CongducPham/PRIMA-Intel-IrriS/README.md

Low-cost LoRa IoT platform for the PRIMA INTEL-IRRIS project
============================================================

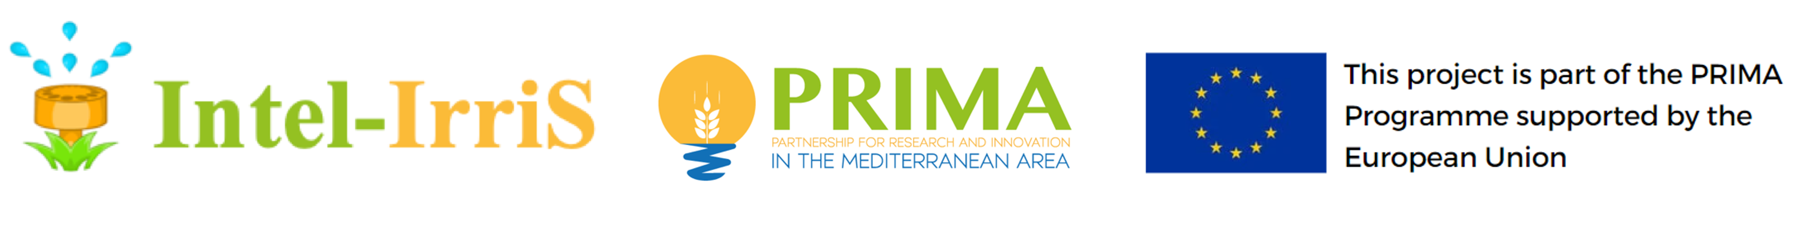
[picture p1: images/intel-irris-logo.png]


We are not maintaining this repo anymore
----------------------------------------

In 2021, we started the [PRIMA INTEL-IRRIS project](https://intel-irris.eu) and this repo. Then, in 2025, as our works in INTEL-IRRIS are continuing in the [PEPR AgriFutur project](https://iotsensingsystem.live-website.com/pepr-agroeconum-agrifutur), at time of writing, the latest edge-enabled gateway we are building on top of the general WaziGate framework provided by WAZIUP e.V is available from the dedicated [PEPR AgriFutur GitHub](https://github.com/CongducPham/PEPR_AgriFutur). Check our latest development on this PEPR AgriFutur GitHub repo. 

History
-------

- **May-24** [Final events](https://intel-irris.eu/final-intel-irris-events) in Oran (Algeria) and Rabat (Morocco) to present the results of 3 years of collaborative research and innovation.

- **Nov-21** We created the GitHub repository for the PRIMA/EU INTEL-IRRIS project. Check project [web site](http://intel-irris.eu/), the dedicated [News section](https://intel-irris.eu/news) and follow us on [Twitter](https://twitter.com/Intel_IrriS).

Quick start
-----------

The [Arduino sketch](https://github.com/CongducPham/PRIMA-Intel-IrriS/tree/main/Arduino/Intelirris_Soil_Sensor) for the soil sensor device is in the [Arduino folder](https://github.com/CongducPham/PRIMA-Intel-IrriS/tree/main/Arduino).

The INTEL-IRRIS gateway part is based on the [WaziGate](https://github.com/Waziup/WaziGate) framework.

The WaziGate generic framework is enhanced with INTEL-IRRIS specific UI and irrigation data processing. These additional contributions are in the `Gateway` folder **but the SD card image has already everything installed**.

The INTEL-IRRIS WaziGate SD card image is available on [http://intel-irris.eu/results](http://intel-irris.eu/results). It is configured by default for 868MHz frequency band. To use 433MHz frequency band, see the [433MHz auto-configuration mechanism](https://github.com/CongducPham/PRIMA-Intel-IrriS/tree/main/Gateway/boot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).

Default configuration for the gateway
---

- LoRaWAN mode (single channel)
- Cayenne LPP data format
- EU868 band (suitable for Algeria. For Morocco, need to use 433MHz)
- 2 pre-configured devices with address 26011DAA and 26011DB1
- 26011DAA is a soil humidity device with the capacitive SEN0308 sensor
	- Device name is `SOIL-AREA-1`
	- `temperatureSensor_0` as the internal default logical sensor on the WaziGate for soil humidity data. Display will show `Soil Humidity Sensor/Raw value from SEN0308`
	- `temperatureSensor_5` as the internal default logical sensor on the WaziGate for the soil temperature data if a DS18B20 is connected. Display will show `Soil Temperature Sensor/degree Celcius`
	- `analogInput_6` as the internal default logical sensor for battery voltage. Display will show `Battery voltage/volt, low battery whebn lower than 2.85V`
- 26011DB1 is a soil humidity device with the Watermark WM200 tensiometer sensor
	- Device name is `SOIL-AREA-2`
	- `temperatureSensor_0` as the internal default logical sensor on the WaziGate for soil humidity data. It provides the converted resistance value in centibar, Taking into account the soil temperature data. Display will show `Soil Humidity Sensor/centibars from WM200`
	- `temperatureSensor_1` as the internal default logical sensor on the WaziGate for soil humidity data. It provides the raw resistance value measured from the Watermark sensor. The value is scaled down by 10, so to get the real resistance value one must multiply by 10. Display will show `Soil Humidity Sensor/scaled value from WM200 real=x10`	
	- `temperatureSensor_5` as the internal default logical sensor on the WaziGate for the soil temperature data if a DS18B20 is connected. Display will show `Soil Temperature Sensor/degree Celcius`
	- `analogInput_6` as the internal default logical sensor for battery voltage. Display will show `Battery voltage/volt, low battery whebn lower than 2.85V`

Insert the SD card in the Raspberry Pi and then power the RPI. The INTEL-IRRIS WaziGate is ready when the main INTEL-IRRIS screen appears on the OLED indicating `SOIL-AREA-1` and `SOIL-AREA-2` devices. You may see a succession of `[ Internet NO ]` and/or `[ Internet OK ]` and black screen before the main INTEL-IRRIS screen appears on the OLED.

More information in the [`Gateway`](https://github.com/CongducPham/PRIMA-Intel-IrriS/tree/main/Gateway) folder.

**Note: The 2 default devices are created on first boot with the auto-configuration mechanism. Consider about 5mins as normal for boot time. If you change the frequency band, the gateway will take more time to start as it needs to boot twice. Therefore 10mins would be needed for first start to have the main INTEL-IRRIS screen on the OLED.**

Tutorials
---------

General presentation of the PRIMA INTEL-IRRIS project

- [Intel-IrriS’s presentation slides](http://cpham.perso.univ-pau.fr/LORA/INTEL-IRRIS/Intel-Irris-presentation.pdf)

1 general online tutorial on IoT, Arduino, LoRa, AI 

- [Arduino-Sensor-LoRa tutorial](https://cpham.perso.univ-pau.fr/LORA/WAZIUP/tuto/index.html)

The generic low-cost IoT framework from which the INTEL-IRRIS platform is derived

- [Low-cost IoT framework](https://github.com/CongducPham/LowCostLoRaGw)

The WaziGate edge-enabled IoT gateway framework developed by WAZIUP

- [WaziGate presentation](https://www.waziup.io/documentation/wazigate/)

INTEL-IRRIS specific tutorials

- [Building the INTEL-IRRIS IoT platform. Part 1: soil sensor device (all versions)](https://github.com/CongducPham/PRIMA-Intel-IrriS/blob/main/Tutorials/Intel-Irris-IOT-platform-all-version.pdf). Slides. Related videos: Video n°1, Video n°2 and Video n°3.

- [Building the INTEL-IRRIS IoT platform. Part 1: soil sensor device (IRD PCB and IRD PCBA v4.1)](https://github.com/CongducPham/PRIMA-Intel-IrriS/blob/main/Tutorials/Intel-Irris-IOT-platform-PCBv4-PCBA.pdf). Slides. Related videos: Video n°1, Video n°2 and Video n°3.

- [Building the INTEL-IRRIS IoT platform. Part 2: edge-enabled gateway (WaziGate)](https://github.com/CongducPham/PRIMA-Intel-IrriS/blob/main/Tutorials/Intel-Irris-edge-gateway.pdf). Slides. Related videos: Video n°4.

- [Building the INTEL-IRRIS IoT platform. Part 3: the INTEL-IRRIS starter-kit (WaziGate)](https://github.com/CongducPham/PRIMA-Intel-IrriS/blob/main/Tutorials/Intel-Irris-starter-kit-advanced-guide.pdf). Slides. Related videos: Video n°5.

- [The INTEL-IRRIS starter-kit. Maker Guide.](https://github.com/CongducPham/PRIMA-Intel-IrriS/blob/main/Tutorials/Intel-Irris-starter-kit-maker-guide.pdf). Slides.

- [The INTEL-IRRIS starter-kit. User Guide.](https://github.com/CongducPham/PRIMA-Intel-IrriS/blob/main/Tutorials/Intel-Irris-starter-kit-user-guide.pdf). Slides.

- [The INTEL-IRRIS starter-kit. Installation Guide.](https://github.com/CongducPham/PRIMA-Intel-IrriS/blob/main/Tutorials/Intel-Irris-starter-kit-installation-guide.pdf). Slides.

- Video n°1: [Build the LoRa IoT microcontroller platform for the PRIMA INTEL-IRRIS project](https://youtu.be/3jdQ0Uo0phQ). **YouTube video**.

- Video n°2: [Build the LoRa IoT soil sensor device for the PRIMA INTEL-IRRIS project](https://youtu.be/zcazzDbXvHk). **YouTube video**.

- Video n°3: [Connect the SEN0308 capacitive sensor and test LoRa data transmission on the Edge IoT gateway](https://youtu.be/n0YGan7_vUc). **YouTube video**.

- Video n°4: [Demonstrating the INTEL-IRRIS soil sensor device & WaziGate framework for intelligent irrigation in-the-box](https://youtu.be/j-1Nk0tv0xM). **YouTube video**. 

- Video n°5: [Non-technical video showing the production of the starter-kit](https://youtu.be/5nznRcIoe40). **YouTube video**.

- Video n°6. [Showcasing the starter-kit for the Smallholder Piloting Program](https://youtu.be/z5NL3dBHQ6c). **YouTube video**.

- [Building the INTEL-IRRIS IoT platform. Annex 1: ordering the PCBs, including PCBA](https://github.com/CongducPham/PRIMA-Intel-IrriS/blob/main/Tutorials/Intel-Irris-PCB-update-PCBA.pdf). Slides.

- Video n°9. [Tutorial showing how to order the fully assembled INTEL-IRRIS PCBA](https://youtu.be/ueNRfBzCXiU). **YouTube video**.

- [List of hardware parts for the INTEL-IRRIS soil sensor device](https://github.com/CongducPham/PRIMA-Intel-IrriS/blob/main/Tutorials/Intel-IrriS-low-cost-sensor-hardware-parts.pdf). Document.

The starter-kit
---------

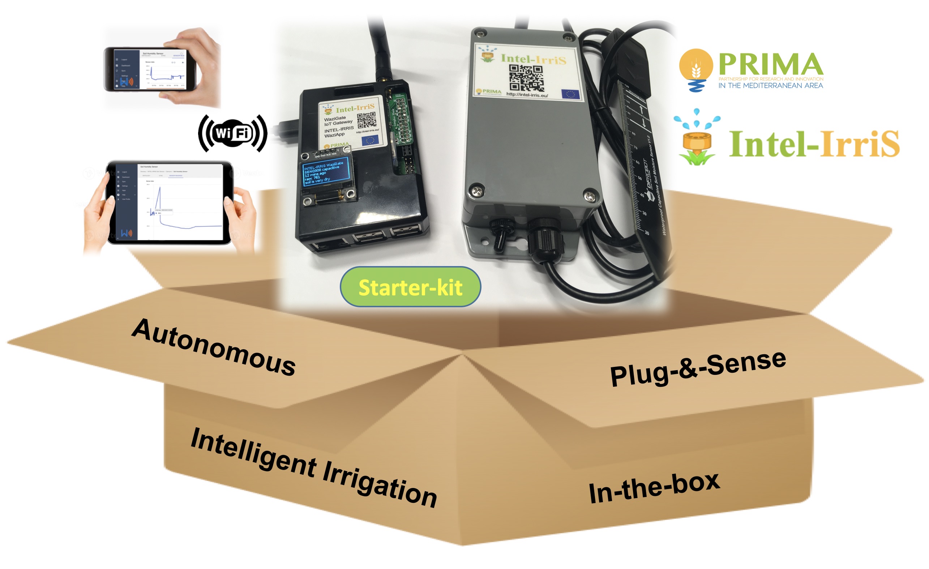
[picture p2: images/starter-kit-bg-white.jpg]




Enjoy!
C. Pham
Coordinator of PRIMA INTEL-IRRIS
