CongducPham/PRIMA-Intel-IrriS/Gateway/oled/README.md

This is a breakdown of all the steps to install the INTEL-IRRIS OLED service on top of the generic WaziGate distribution. The `install.sh` script actually does the installation. 

Expand filesystem if needed
---------------------------

	> sudo raspi-config
	
PIP3 on WaziGate
----------------

	> sudo apt install python3-pip
	
OLED on WaziGate
----------------

More info from https://learn.adafruit.com/monochrome-oled-breakouts/python-setup

	> sudo pip3 install adafruit-circuitpython-ssd1306
	> sudo apt-get install python3-pil
	
then see small example from https://learn.adafruit.com/monochrome-oled-breakouts/python-usage-2

The INTEL-IRRIS OLED service
----------------------------

	> sudo cp intel-irris-oled-service.service.txt /etc/systemd/system/intel-irris-oled-service.service
	> sudo systemctl enable intel-irris-oled-service.service
	
How the OLED service works?
---------------------------

The OLED service (`intel-irris-oled-service.service.txt`) takes some configuration definitions from `oled_config.py`. Then, it will try to discover all devices with either "SEN0308" or "WM200" in their sensor name or sensor kind.

It will display a main screen then a screen saver	by cycling sequentially through all discovered devices. It will display in the screen saver a visual interface to indicate the soil humidity level.



More information on the OLED screen can be found in the [starter-kit slides](https://github.com/CongducPham/PRIMA-Intel-IrriS/blob/main/Tutorials/Intel-Irris-starter-kit.pdf).
