CongducPham/PRIMA-Intel-IrriS/Datasets/plot_scripts/README.md

*Plot scripts*
============================================================

	- new file:   plot_csv_Bondy.py
	- new file:   plot_csv_template.py
	- new file:   plot_json.py

These scripts sum up in plots a dataset based on values extracted from a gateway.
Three formats are supported:
- JSON from Gateway's extraction script
- CSV with a single time column from Gateway's extraction script
- CSV from WaziApp UI's extraction; currently a template of the CSV with a two-line header.
