CongducPham/PRIMA-Intel-IrriS/images/INTEL-IRRIS-wazigate-default-sensor-data.png

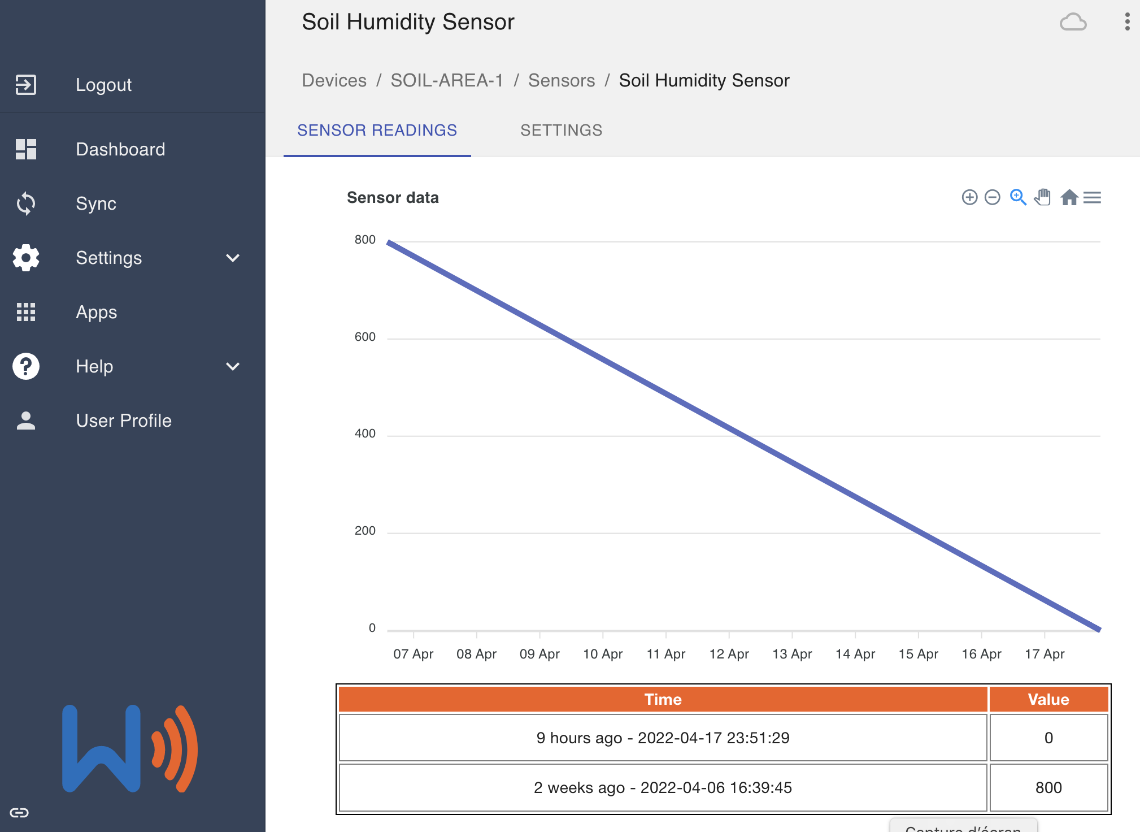
images/INTEL-IRRIS-wazigate-default-sensor-data.png
