CongducPham/PRIMA-Intel-IrriS/images/ProMini-RFM95W-bottom.png

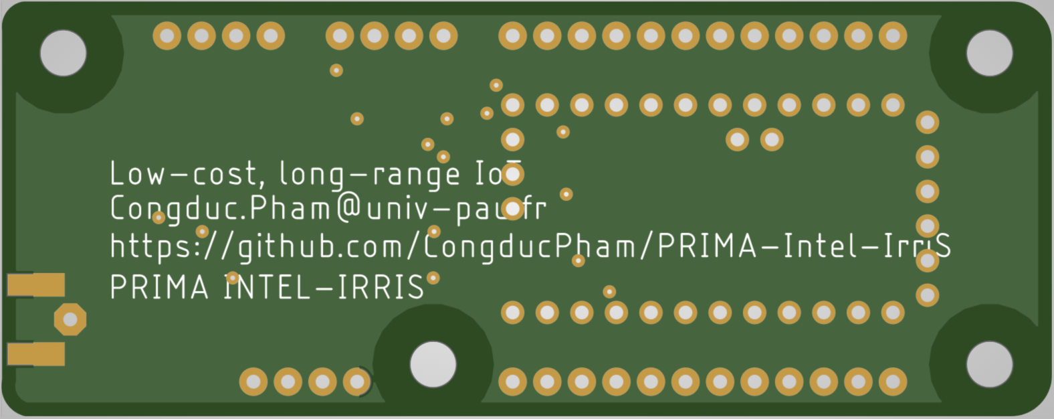
images/ProMini-RFM95W-bottom.png
