CongducPham/PRIMA-Intel-IrriS/images/ProMini-SX128X-bottom.png

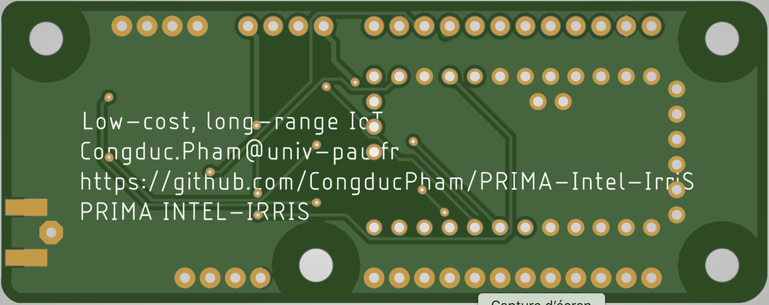
images/ProMini-SX128X-bottom.png
