CongducPham/PRIMA-Intel-IrriS/PCBs/IRD_PCB_5/BOM_SMT_TB_RAK3172_868_IISS_PCB5.xlsx

Name | Designator | Footprint | Quantity | Supplier | Supplier Part | alternative
4.7uF | C2,C5,C6,C7 | 1206 | 4 | LCSC | C92837
100nF | C1,C8 | 603 | 2 | LCSC | C106221 | C42998 | C106221
PZ254V-11-06P | CN25 | HDR-TH_6P-P2.54-V-M | 1 | LCSC | C492405
1k | R11 | 603 | 1 | LCSC | C22548
RAK3172 (EU868, WITHOUT IPEX) | U2 | LCC-40_L15.6-W15.0-P1.00_RAK3172 | 1 | LCSC | C5452091 | C2886287 | C5452091 | C19723908 | C19723904
PZ254V-11-04P | CN1,H2 | HDR-TH_4P-P2.54-V-M | 2 | LCSC | C492403
XY308-2.54-6P | CN8 | CONN-TH_XY308-2.54-6P | 1 | LCSC | C915915 | C915915 | C3817456 | C2922601 | C5188446
XY308-2.54-7P | CN3 | CONN-TH_XY308-2.54-7P | 1 | LCSC | C915916
A2541HWV-12P | CN21,CN20 | HDR-TH_12P-P2.54-V-F | 2 | LCSC | C2905419
A2541HWV-3P | CN22 | HDR-TH_3P-P2.54-V-F-1 | 1 | LCSC | C541850 | C541850 | C22368237 |  | C146243
KH-A2541HWV-2P | CN23 | HDR-TH_2P-P2.54-V-F | 1 | LCSC | C124411 | C541849 | C22368236 | C22438152 | C124411
HJ-SMA716 | RF1 | SMA-SMD_HJ-SMA716 | 1 | LCSC | C496550
TPRT9080-33GJ5 | U1 | SOT-23-5_L2.9-W1.6-P0.95-LS2.8-BR | 1 | LCSC | C841192 | C2959864
SMBJ5.0A | D2 | SMB(DO-214AA) | 1 | LCSC | C473804
10k | R13,R7 | 603 | 2 | LCSC | C98220
4.7k | R9 | 603 | 1 | LCSC | C99782
330pF | C3 | 603 | 1 | LCSC | C2181158
100k | R4,R1,R2,R6 | 603 | 4 | LCSC | C14675
430K | R5 | 603 | 1 | LCSC | C482869
IRLML5203 | Q1,Q2,Q3 | SOT-23-3_L2.9-W1.3-P0.95-LS2.4-BR | 3 | LCSC | C518778
BSS138_C400505 | Q4 | SOT-23-3_L2.9-W1.3-P1.90-LS2.4-BR | 1 | LCSC | C2874697
68 (NC for lithium) | R17 | 603 | 1 | LCSC | C126362
33nF | C4 | 603 | 1 | LCSC | C106856
SS14S-SMA | D1 | SMA_L4.3-W2.6-LS5.0-RD | 1 | LCSC | C2837270
