CongducPham/PRIMA-Intel-IrriS/Tutorials/Intel-Irris-IOT-platform-PCBv5-PCBA.pdf

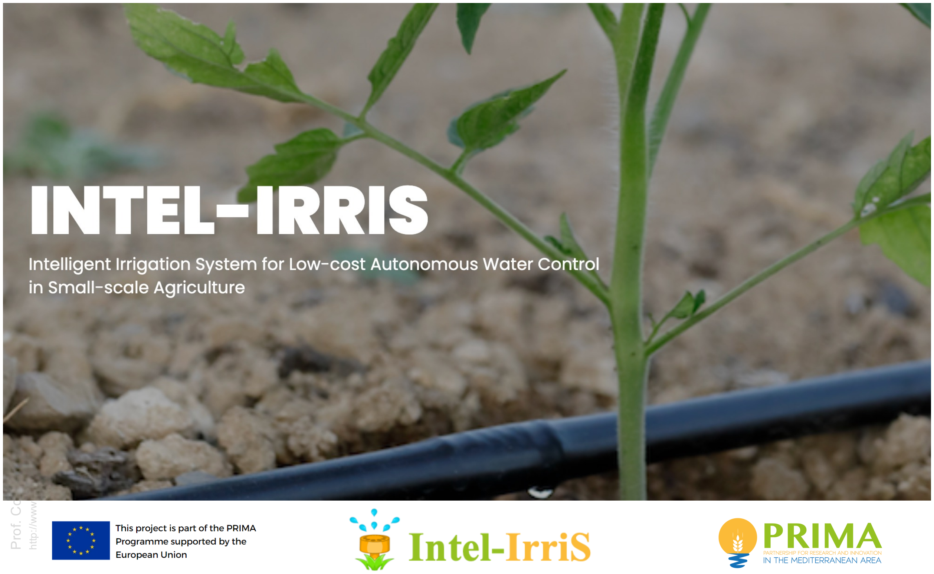
[picture p39: page 1]

1

Prof. Congduc Pham

http://www.univ-pau.fr/~cpham

### Intelligent Irrigation System for Low-cost Autonomous Water Control in Small-scale Agriculture

# Building the INTEL-IRRIS LoRa IoT platform Part 1: soil sensor device

## (annex for IRD PCB v5 – RAK3172)

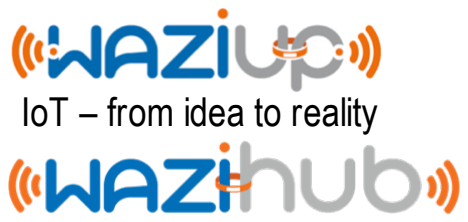
[picture p40: figure]
IoT – from idea to reality
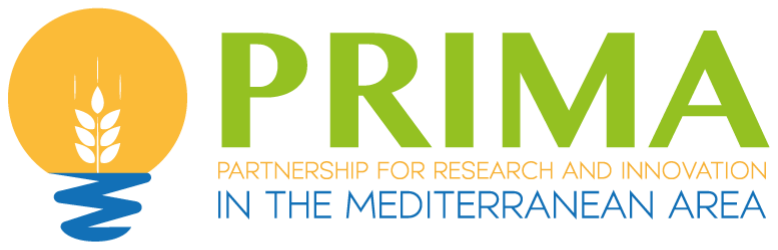
[picture p41: figure]

Prof. Congduc Pham
http://www.univ-pau.fr/~cpham Université de Pau, France

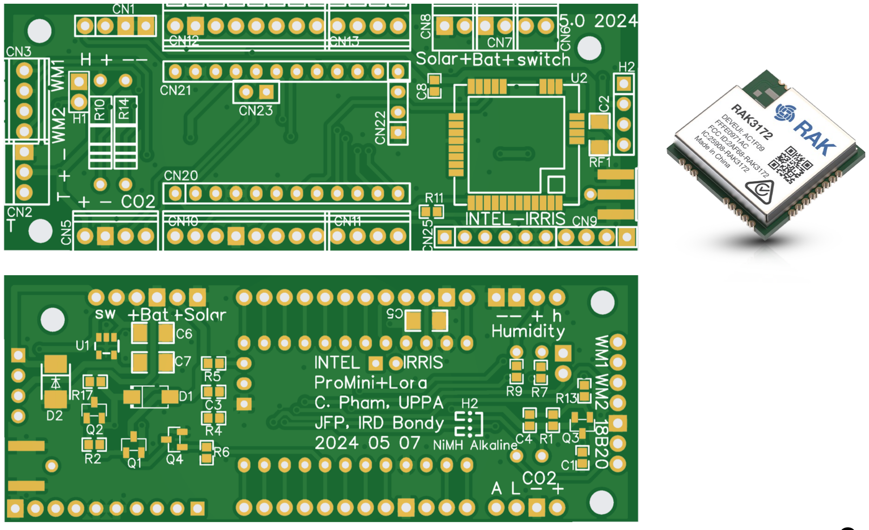
[picture p42: figure]
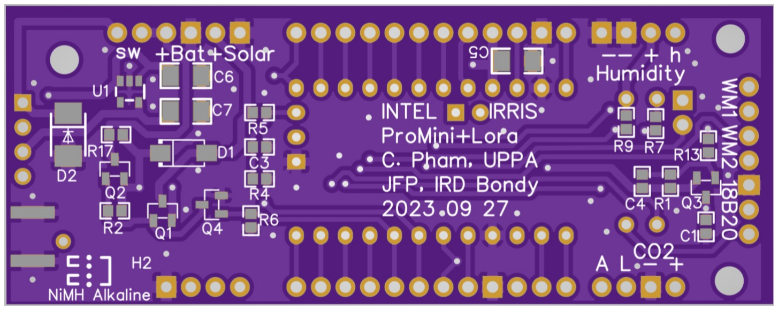
[picture p43: figure]

3

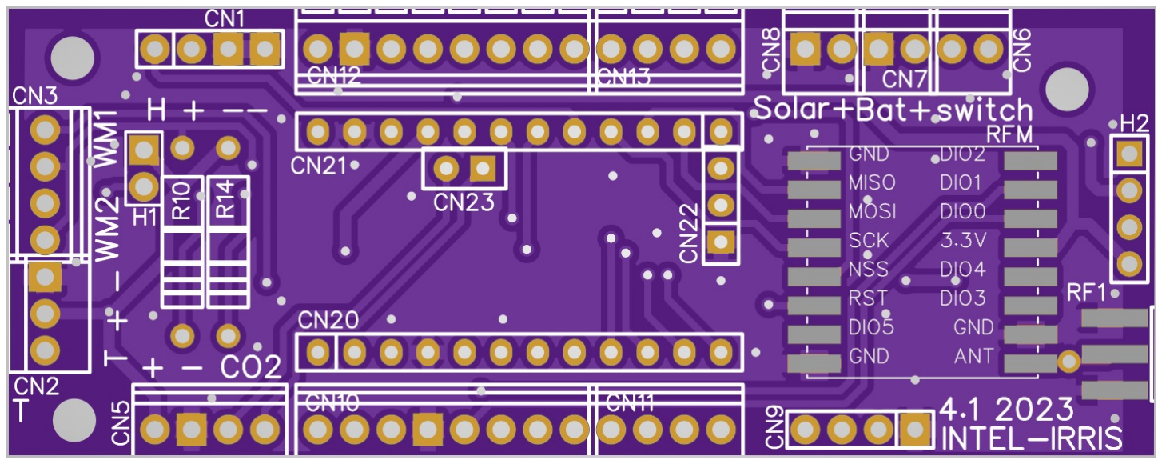
[picture p44: figure]

Prof. Congduc Pham

http://www.univ-pau.fr/~cpham

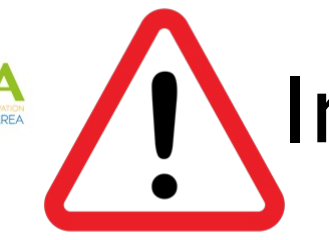
[picture p45: figure]

## Important

⊙ This tutorial is an update for the IRD PCB v5 based on the RAK3172 radio module
⊙ Reader MUST first look at the tutorial presenting the IRD PCB v4.1
⊙ This tutorial only presents the differences between the 2 versions

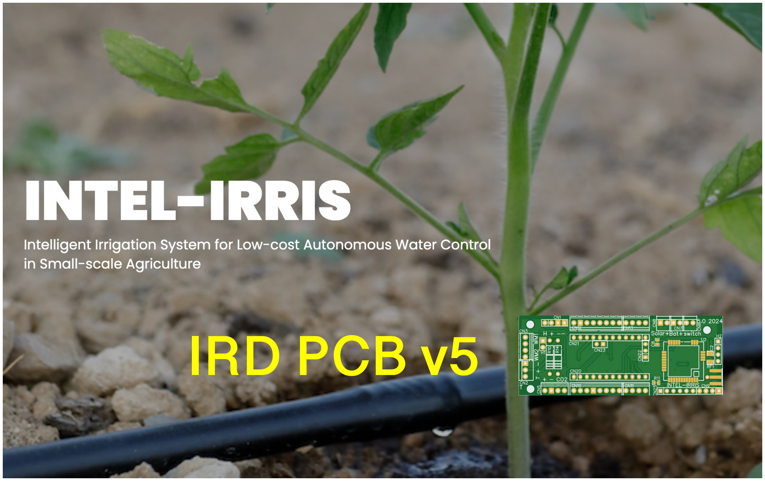
[picture p46: page 4]

# IRD PCB v5

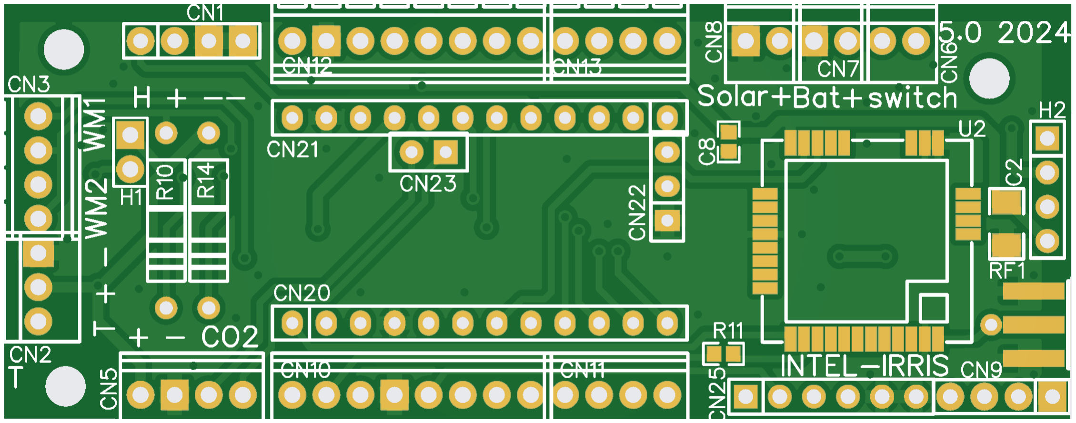
[picture p47: figure]
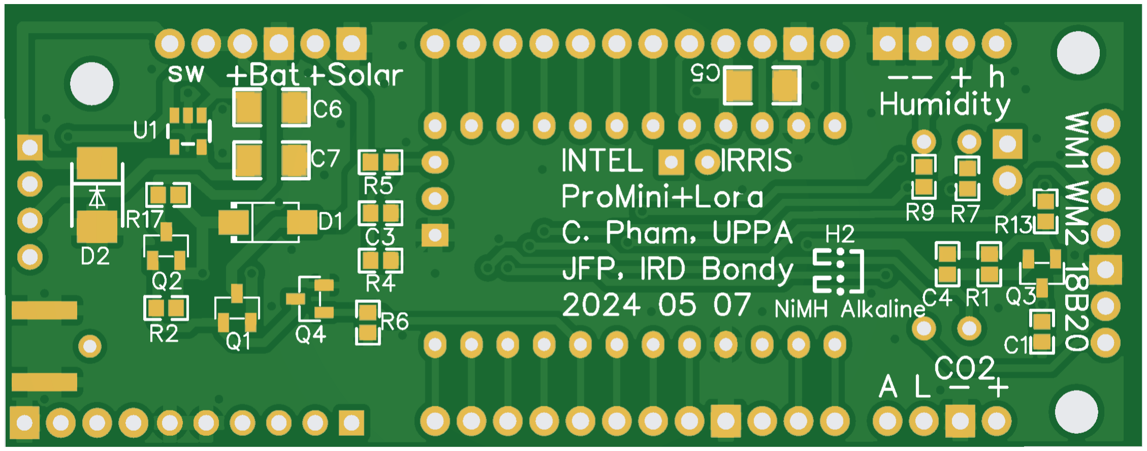
[picture p48: figure]

5

Prof. Congduc Pham

http://www.univ-pau.fr/~cpham

## The IRD PCB v5 – raw version

⊙ You can order the raw version of the IRD PCB, which means only the PCB, without any electronic components soldered by the manufacturer
⊙ It is the so-called
DIY approach
⊙ The raw version is not
intended to have solar
charging capabilities

## Electronic parts – starter-kit version

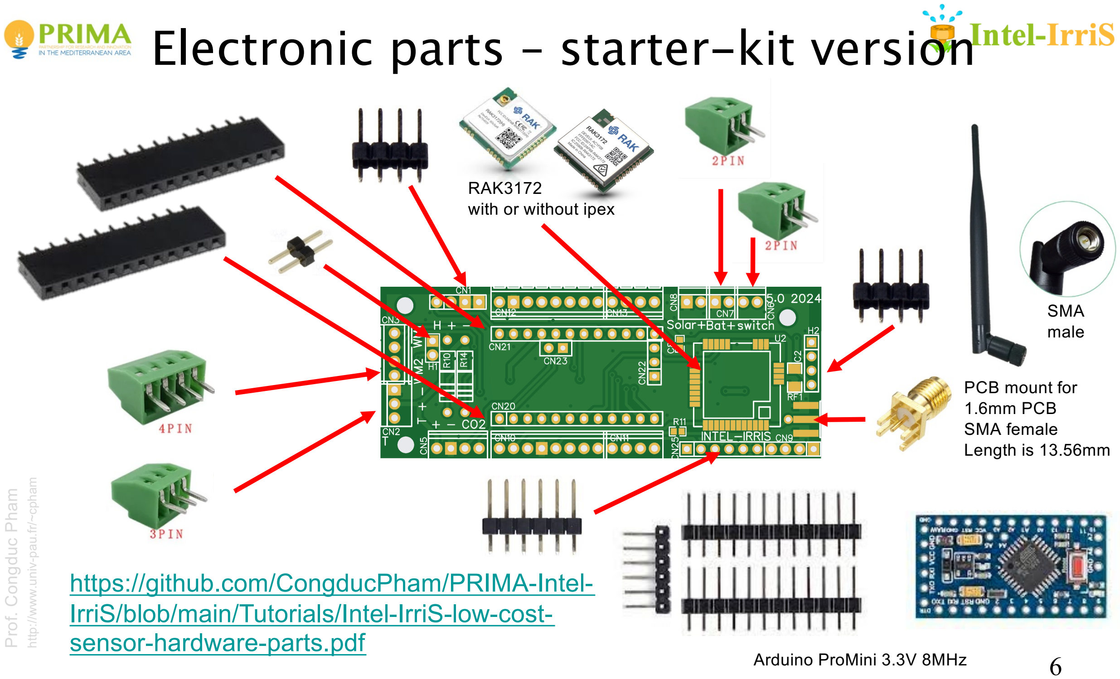
[picture p49: page 6]

6

Prof. Congduc Pham

http://www.univ-pau.fr/~cpham

PCB mount for
1.6mm PCB
SMA female
Length is 13.56mm

Arduino ProMini 3.3V 8MHz

SMA
male

https://github.com/CongducPham/PRIMA-Intel-IrriS/blob/main/Tutorials/Intel-IrriS-low-cost-sensor-hardware-parts.pdf (https://github.com/CongducPham/PRIMA-Intel-IrriS/blob/main/Tutorials/Intel-IrriS-low-cost-sensor-hardware-parts.pdf)

RAK3172
with or without ipex

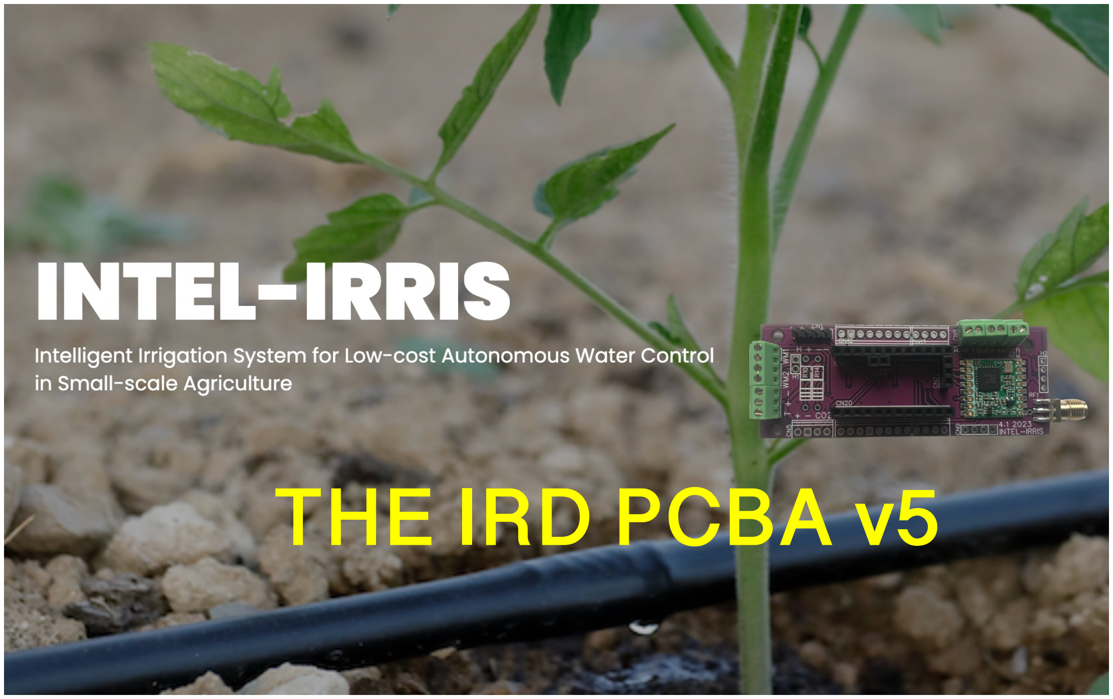
[picture p50: page 7]

# THE IRD PCBA v5

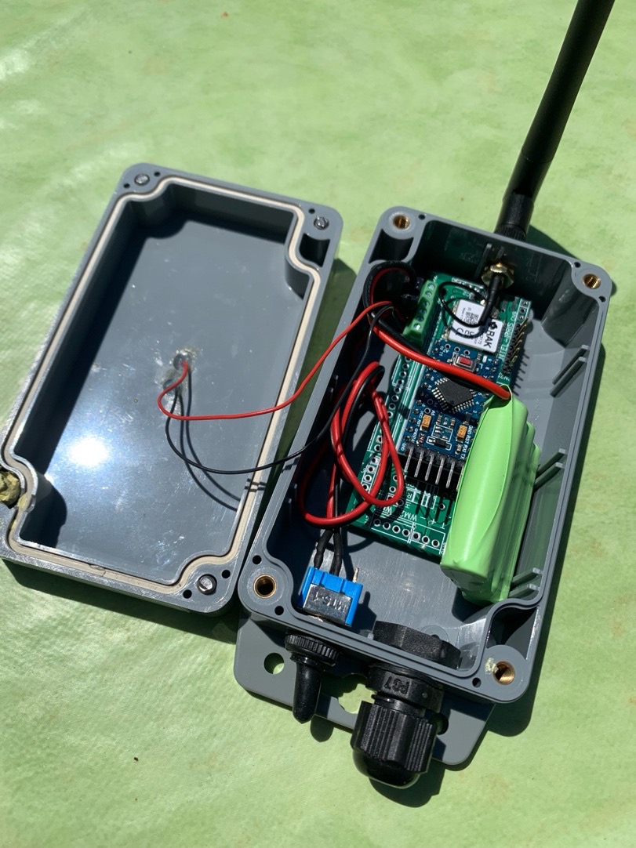
[picture p51: figure]

8

Prof. Congduc Pham

http://www.univ-pau.fr/~cpham

## Soil device with PCBA v5, final result

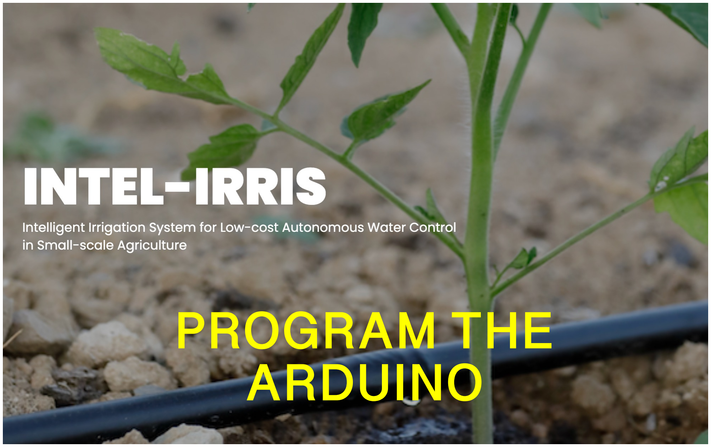
[picture p52: page 9]

# PROGRAM THE ARDUINO

## Config for IRD PCB v5 (1)

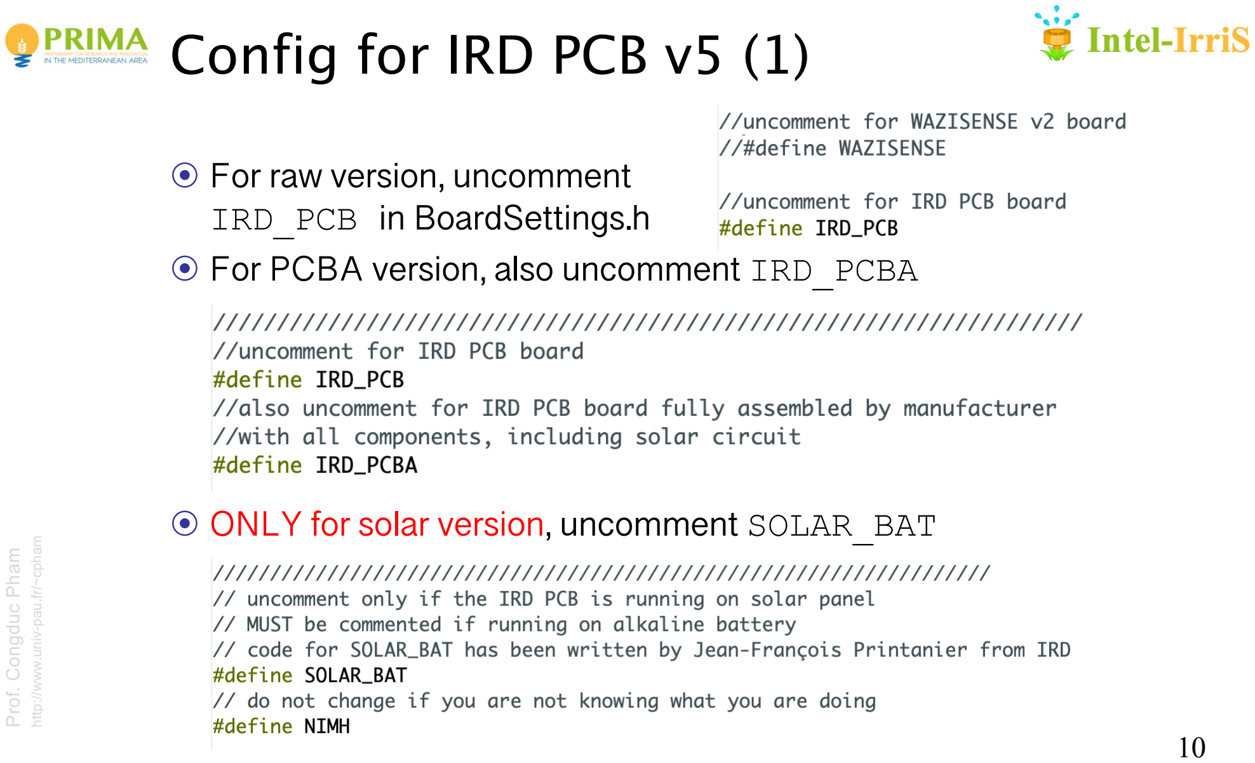
[picture p53: page 10]

10

Prof. Congduc Pham

http://www.univ-pau.fr/~cpham

⊙ For raw version, uncomment
IRD_PCB in BoardSettings.h
⊙ For PCBA version, also uncomment IRD_PCBA

⊙ ONLY for solar version, uncomment SOLAR_BAT

11

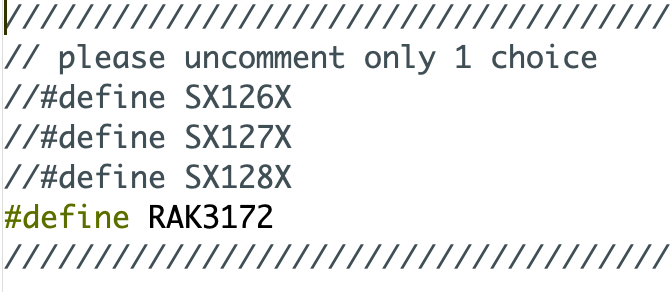
[picture p54: figure]

Prof. Congduc Pham

http://www.univ-pau.fr/~cpham

## Config for IRD PCB v5 (2)

⊙ Uncomment SOFT_SERIAL_DEBUG in BoardSettings.h

⊙ Uncomment RAK3172 in RadioSettings.h

12

Prof. Congduc Pham

http://www.univ-pau.fr/~cpham

## Serial monitor with IRD PCB v5

⊙ After flashing the Arduino, it is usually desirable to watch at the text output from the Arduino IDE serial monitor to check that everything went OK
⊙ With IRD PCB v5, the RAK radio module is controlled by AT commands received on its serial port and sent by the Arduino on its serial port (baud rate is normally set to 38400)
⊙ Therefore, Arduino's TX/RX pins are connected to the
RAK3172 and the serial monitor used traditionally to look at text output can not use the default Arduino TX/RX pins
⊙ The IRD PCB v5 uses a software defined serial port for the text output where only TX is defined on digital pin 2

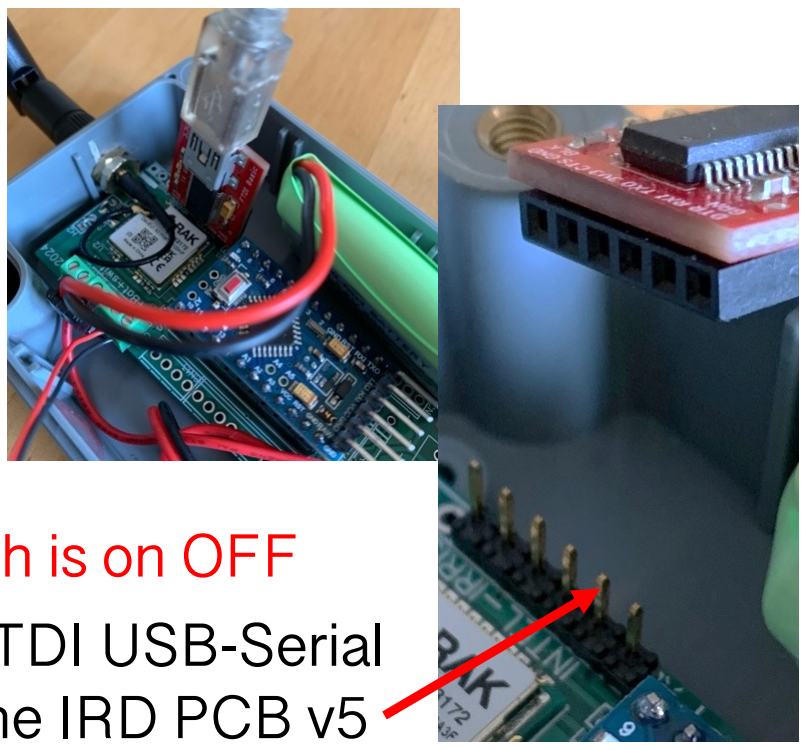
[picture p55: figure]

13

Prof. Congduc Pham

http://www.univ-pau.fr/~cpham

## Connect the FTDI USB-Serial

⊙ After flashing the Arduino with the FTDI USB-Serial cable (left photo), unplug it in order to plug it again on the dedicated debug header on the IRD PCB v5 (middle & right photo)

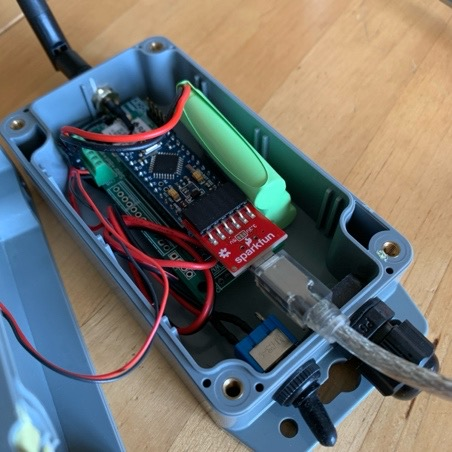
[picture p56: figure]
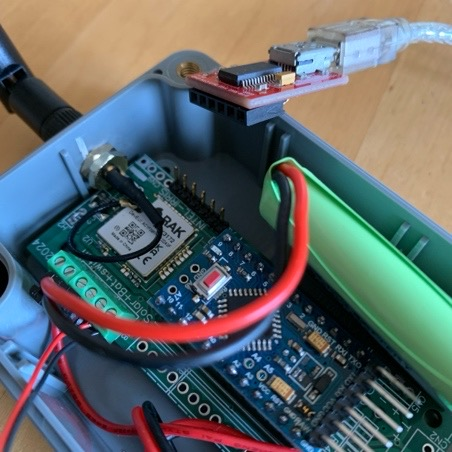
[picture p57: figure]

⊙ Battery should be connected, but switch is on OFF
⊙ Be sure to connect the RX pin of the FTDI USB-Serial to the TX pin of the debug header on the IRD PCB v5

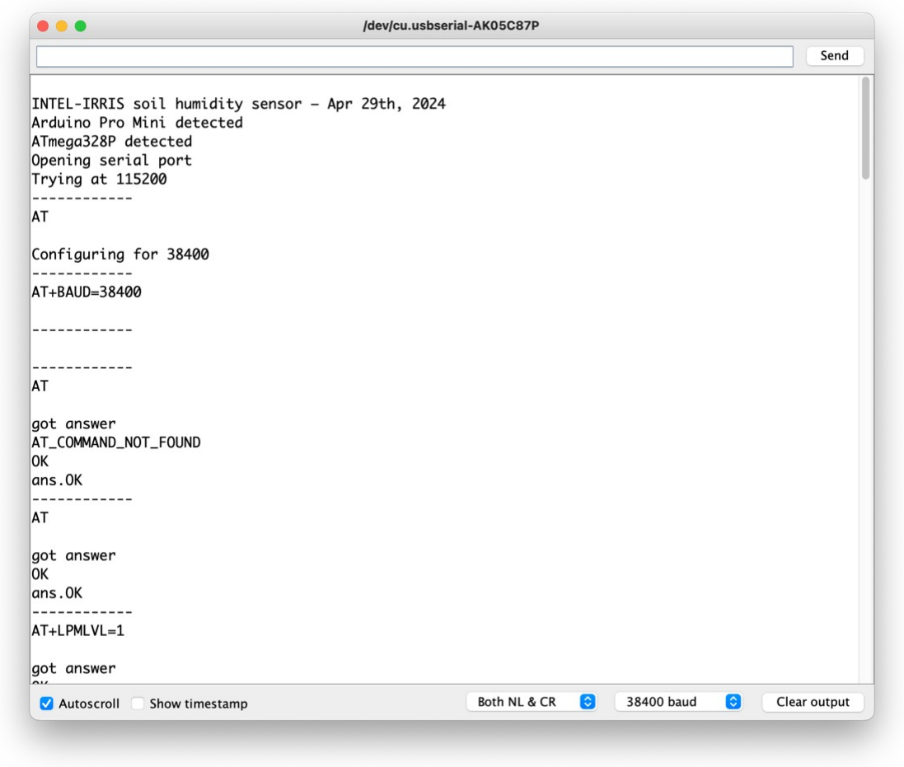
[picture p58: figure]

14

Prof. Congduc Pham

http://www.univ-pau.fr/~cpham

## Getting text output from the board

⊙ Order of steps is important!

Open serial monitor,
you should see nothing

Set baud rate to 38400

Switch ON the board

See output from board

Check that
transmission is OK

15

Prof. Congduc Pham

http://www.univ-pau.fr/~cpham

## Annex: RAK3172 baud rate

⊙ Latest version of RAK3172 is using by default (factory setting) a baud rate of 115200, which is too fast (mostly for RX) for the Arduino Pro mini based on ATMega328P microcontroller
⊙ The INTEL-IRRIS code is actually reprogramming the
RAK3172 to use a baud rate of 38400, therefore you do not need to worry about setting the correct baud rate for RAK3172, especially with the fully assembled version of the PCB where the RAK3172 is provided by the PCB manufacturer

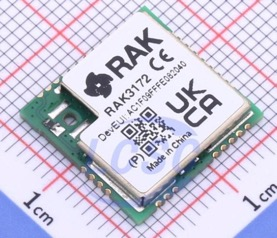
[picture p59: figure]
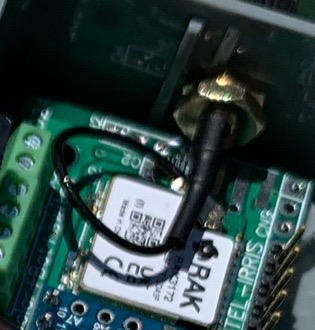
[picture p60: figure]

16

Prof. Congduc Pham

http://www.univ-pau.fr/~cpham

## Annex: IPEX or not IPEX?

⊙ The BOM file for the PCBA fully assembled is using the RAK3172 without the IPEX connector because we prefer to have a robust soldered RF connector

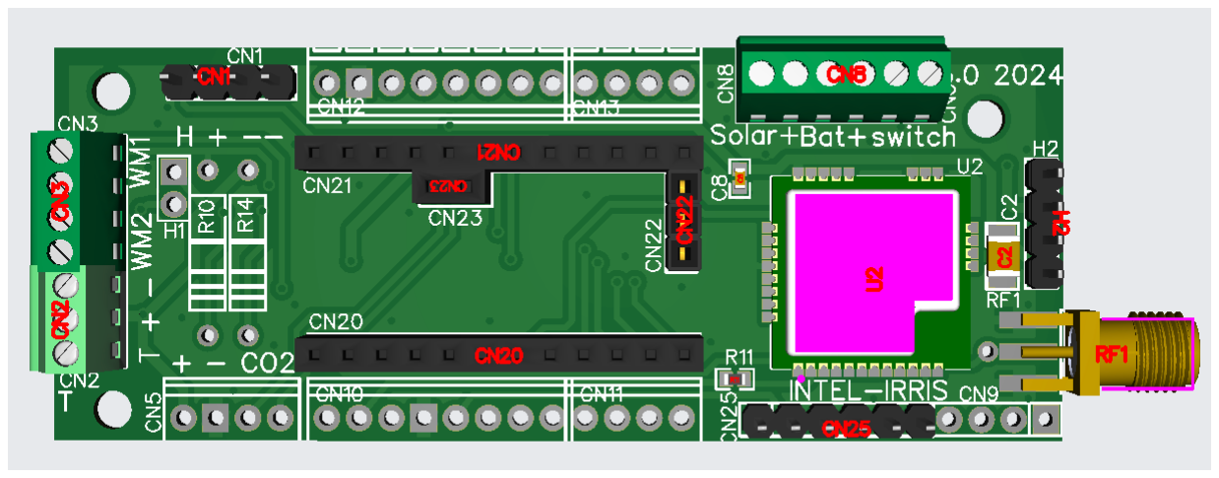
[picture p61: figure]

⊙ For the raw version of the PCB, you can use and solder the version with the IPEX if you want and

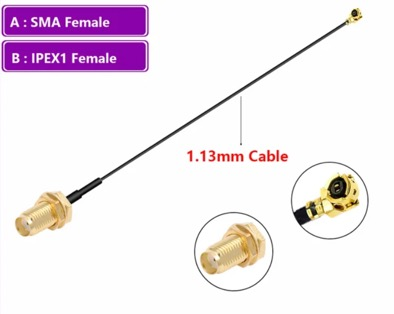
[picture p62: figure]

connect the antenna with an IPEX-female to SMA female short pigtail

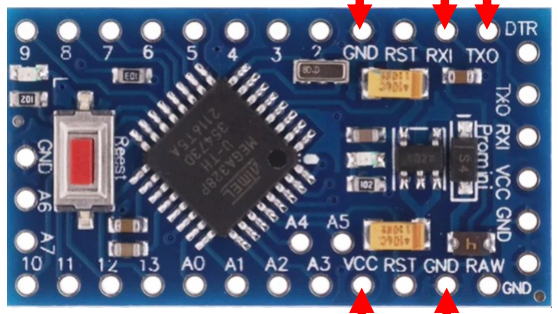
[picture p63: figure]
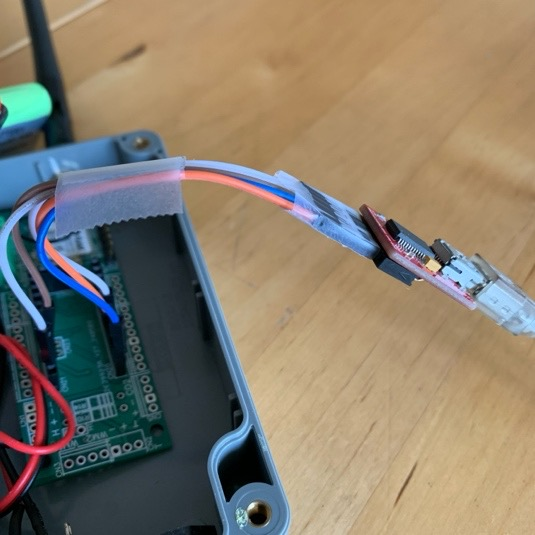
[picture p64: figure]
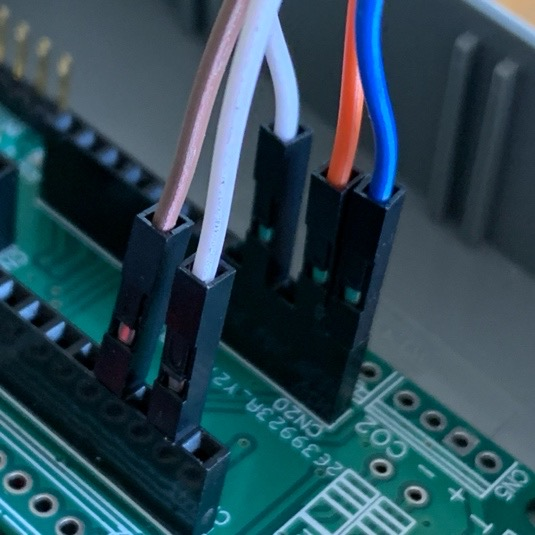
[picture p65: figure]
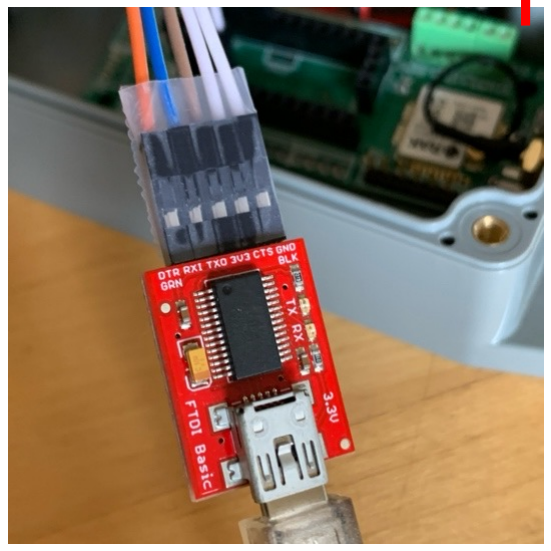
[picture p66: figure]

17

Prof. Congduc Pham

http://www.univ-pau.fr/~cpham

## Annex: update firmware of RAK3172

⊙ The RAK3172 can be upgraded with the RAK DFU tool
⊙ You can use Dupont wires to directly connect
VCC, GND, RX and TX of the FTDI USB-serial
cable to corresponding pins on the female
headers after removing the Arduino Pro Mini from its socket. DTR is not connected

Prof. Congduc Pham

http://www.univ-pau.fr/~cpham

## Annex: send direct AT commands

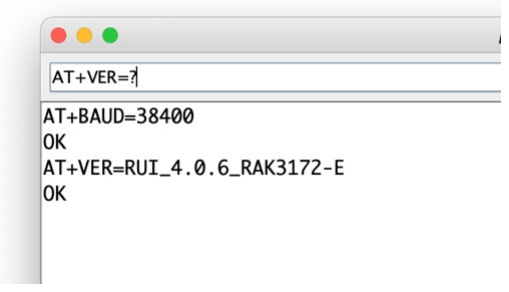
[picture p67: figure]

⊙ With the FTDI USB-serial cable
connected to the PCB v5 without
the Arduino Pro Mini, as show on the previous slide, you can directly communicate with the RAK3172 to send AT commands for test
purposes
⊙ Any serial communication tool can be used, including the Arduino IDE serial monitor

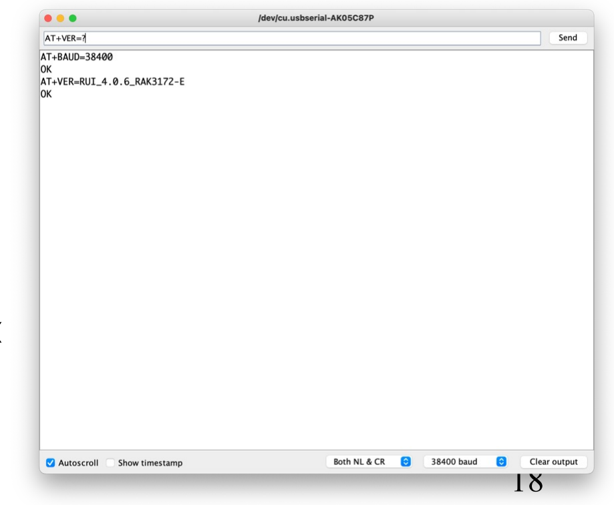
[picture p68: figure]

⊙ RAK also proposes the WisToolBox software to communicate with RAK components

19

Prof. Congduc Pham

http://www.univ-pau.fr/~cpham

## Annex: AT commands for INTEL-IRRIS

⊙ Here is the list of AT commands used by INTEL-IRRIS code
⊙ During setup(), for ABP mode in EU868 band, for capacitive

⊙ AT+BAUD=38400
⊙ AT+LPMLVL=1
⊙ AT+LPM=0
⊙ AT+LPM=? ; AT+VER=? ; AT+BAND=? ; AT+ADR=? ; AT+NJM=? ; AT+DEVADDR=?; AT+NWKSKEY=? ; AT+APPSKEY=?
⊙ AT+NJM=0 ; AT+CLASS=A ; AT+BAND=4 ; AT+ADR=0
⊙ AT+DEVADDR=26011DAA
⊙ AT+NWKSKEY=23158D3BBC31E6AF670D195B5AED5525 ⊙ AT+APPSKEY=23158D3BBC31E6AF670D195B5AED5525
⊙ AT+LPMLVL=2
⊙ AT+LPM=1
⊙ On wake up, to transmit (898.0 and 3.45 for instance)

⊙ AT+SEND=1:0067231406020159
⊙ AT+SLEEP
