CongducPham/PRIMA-Intel-IrriS/Tutorials/Intel-Irris-gateway-outdoor.pdf

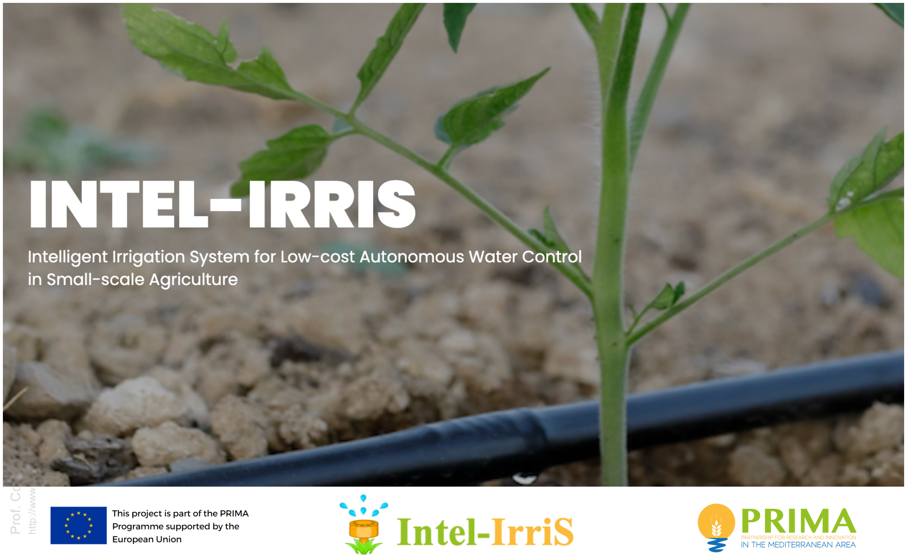
[picture p69: page 1]

1

Prof. Congduc Pham

http://www.univ-pau.fr/~cpham

# Intelligent Irrigation System for Low-cost Autonomous Water Control in Small-scale Agriculture

# Building the INTEL-IRRIS LoRa IoT platform Part 5: outdoor gateway

IoT – from idea to reality

Prof. Congduc Pham
http://www.univ-pau.fr/~cpham Université de Pau, France

3

Prof. Congduc Pham

http://www.univ-pau.fr/~cpham

# Before we start

## ⊙ Look at the tutorial on how to build the simple INTEL-IRRIS gateway

## ⊙ Tutorial slides on building the INTEL-IRRIS IoT platform. Part 2: edge-enabled gateway ⊙ https://docs.google.com/viewer?url=https://github.com/CongducPham/P

RIMA-Intel-IrriS/raw/main/Tutorials/Intel-Irris-edge-gateway.pdf (https://docs.google.com/viewer)

## ⊙ Associated YouTube video ⊙ https://youtu.be/j-1Nk0tv0xM

# Overview of the additional parts

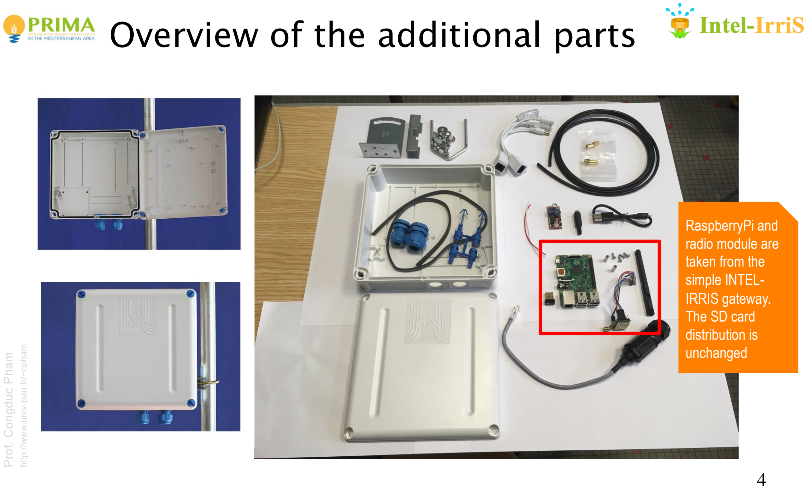
[picture p70: page 4]

4

Prof. Congduc Pham

http://www.univ-pau.fr/~cpham

RaspberryPi and
radio module are
taken from the
simple INTEL-IRRIS gateway.
The SD card
distribution is
unchanged

# Fixing the Raspberry to the case

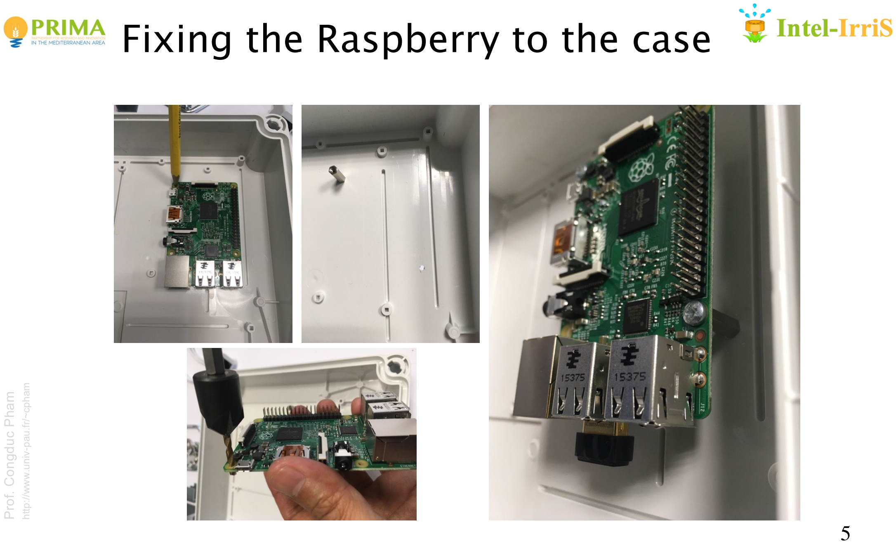
[picture p71: page 5]

5

Prof. Congduc Pham

http://www.univ-pau.fr/~cpham

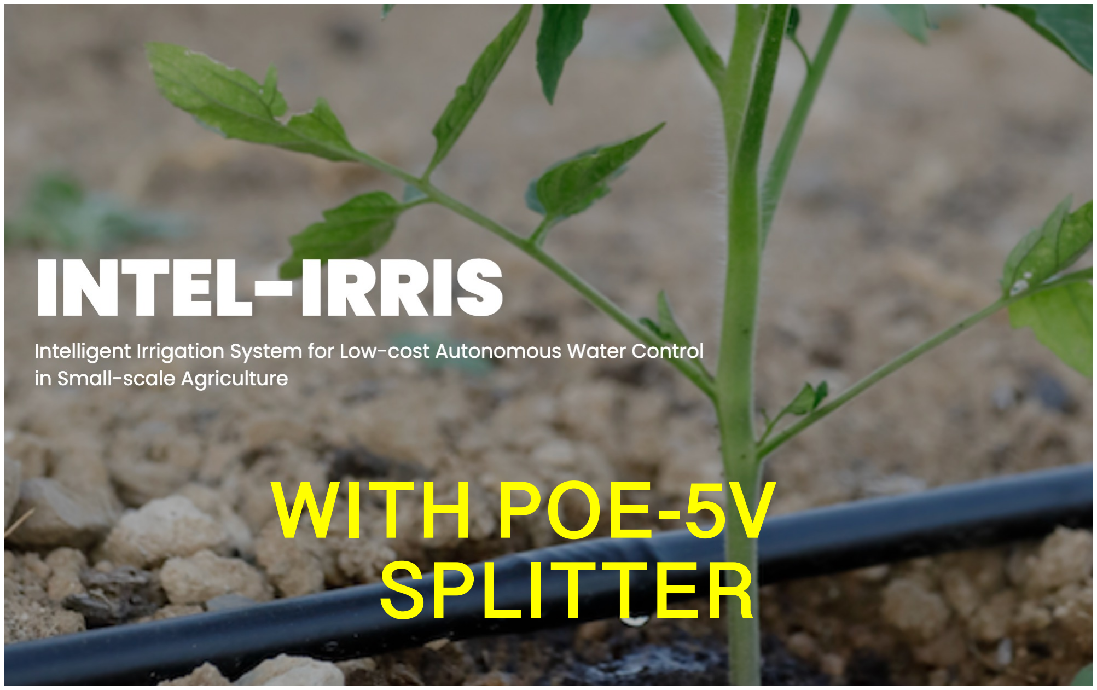
[picture p72: page 6]

# WITH POE-5V SPLITTER

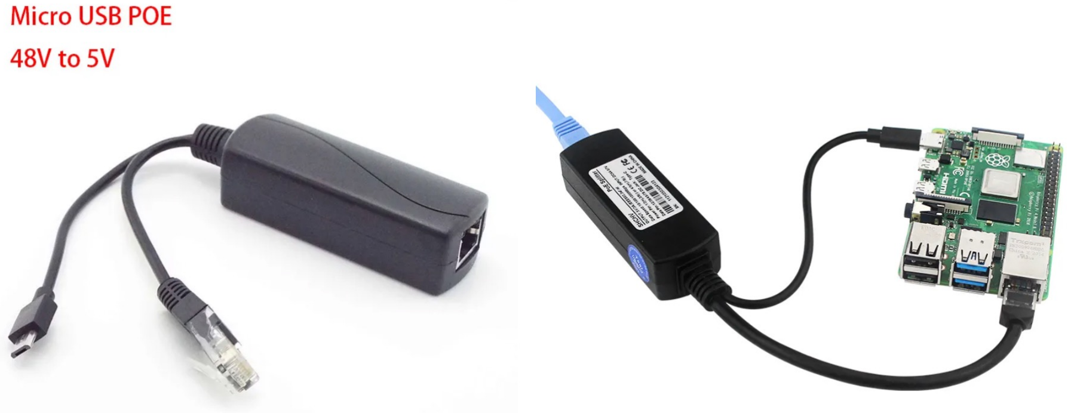
[picture p73: figure]

7

Prof. Congduc Pham

http://www.univ-pau.fr/~cpham

# Using a PoE – micro USB 5V

# Power with PoE adaptor or PoE switch

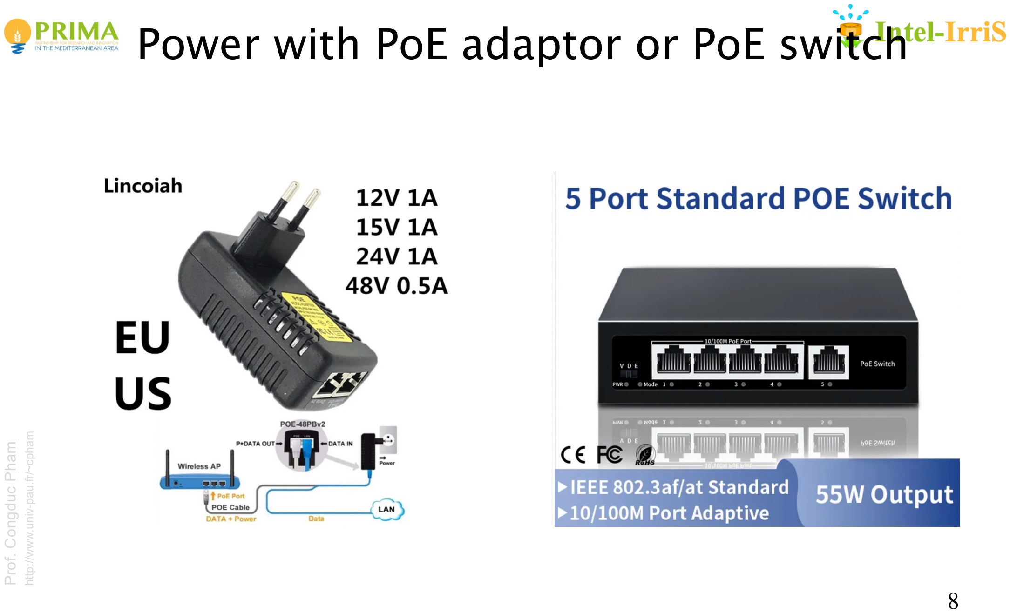
[picture p74: page 8]

8

Prof. Congduc Pham

http://www.univ-pau.fr/~cpham

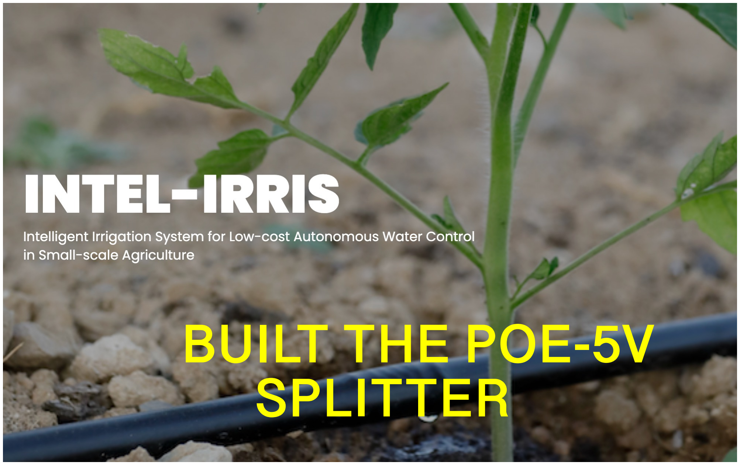
[picture p75: page 9]

# BUILT THE POE-5V SPLITTER

10

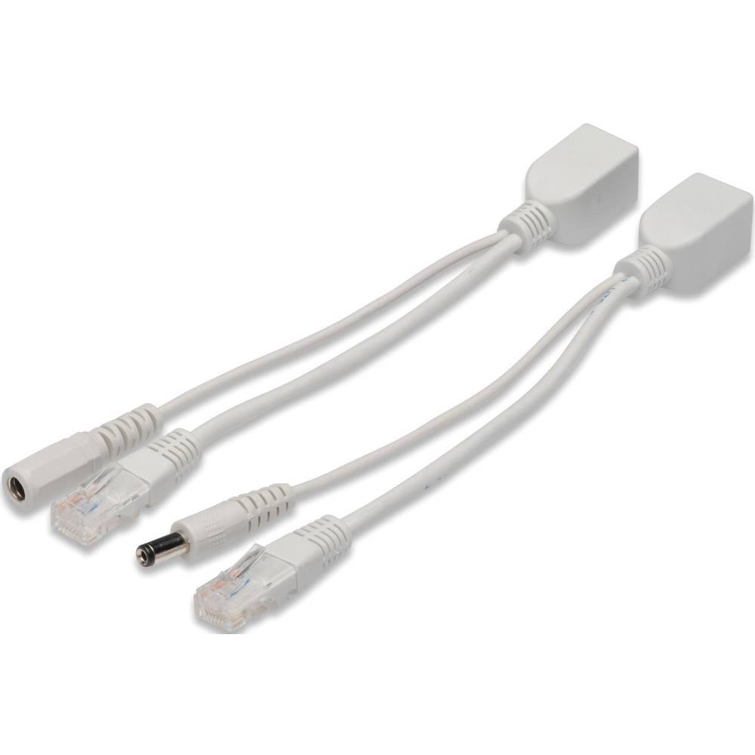
[picture p76: figure]
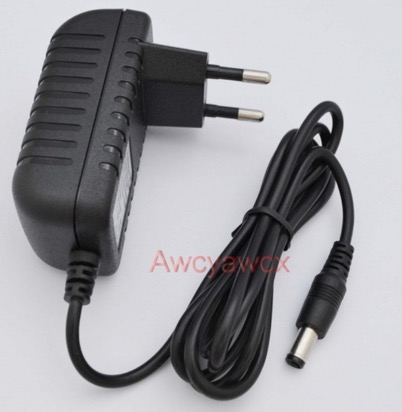
[picture p77: figure]

Prof. Congduc Pham

http://www.univ-pau.fr/~cpham

# 1/ Get a simple PoE splitter

## ⊙ Simple PoE splitter can be connected to AC/DC adaptor (usually 5.5 mm / 2.1 mm)

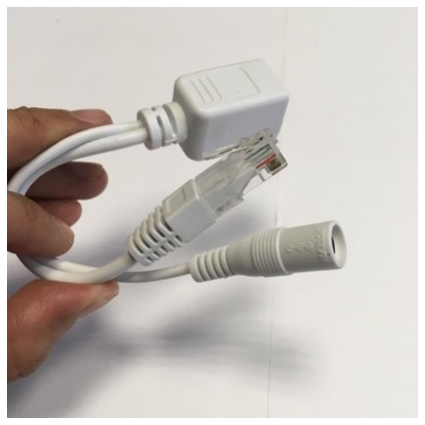
[picture p78: figure]

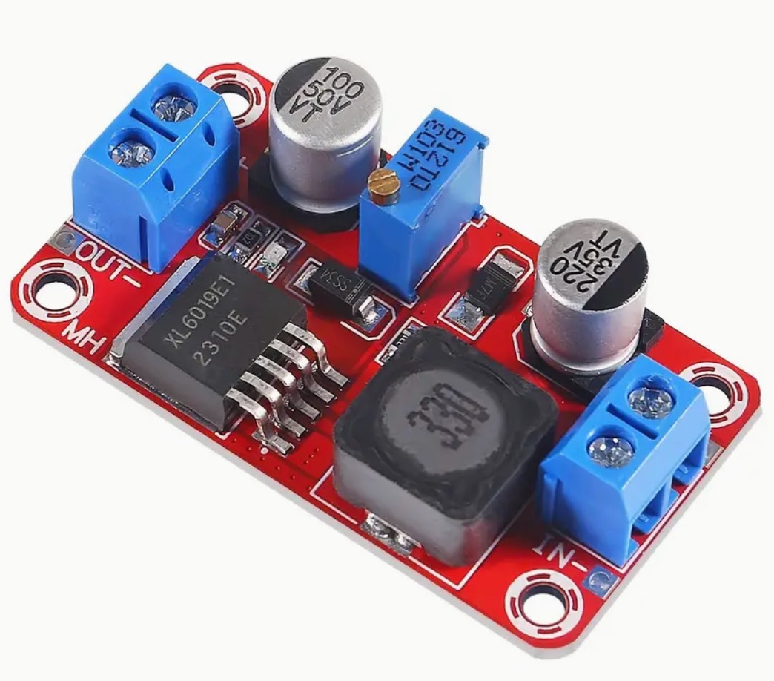
[picture p79: figure]

11

Prof. Congduc Pham

http://www.univ-pau.fr/~cpham

# 2/ Use a DC-DC step down

## ⊙ Most popular are based on LM2596 module, but there are much newer modules ⊙ Any DC-DC module that delivers 5V and at least 2A is OK

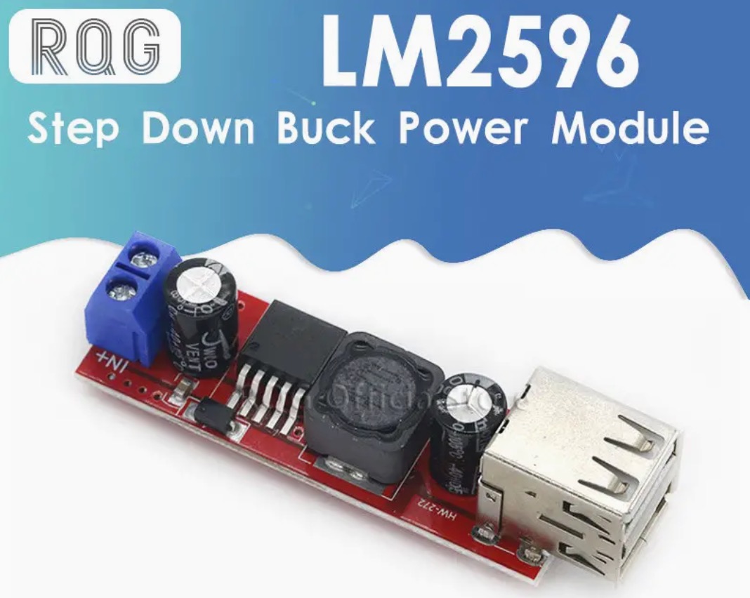
[picture p80: figure]
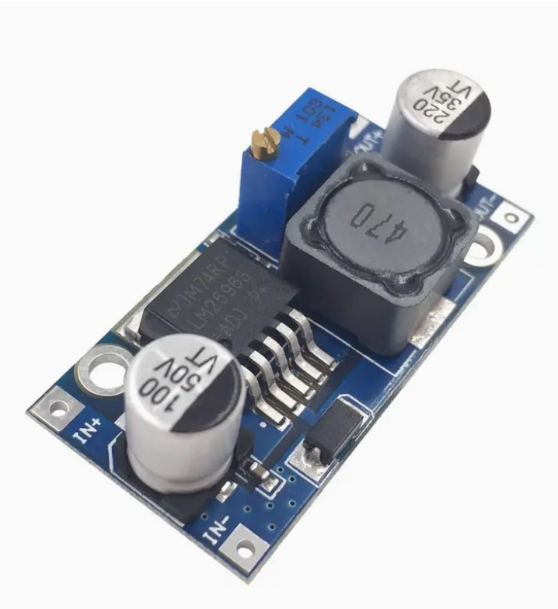
[picture p81: figure]

## ⊙ Final assembling depends on which module you have

# Ex: Simple DC-DC based on LM2596

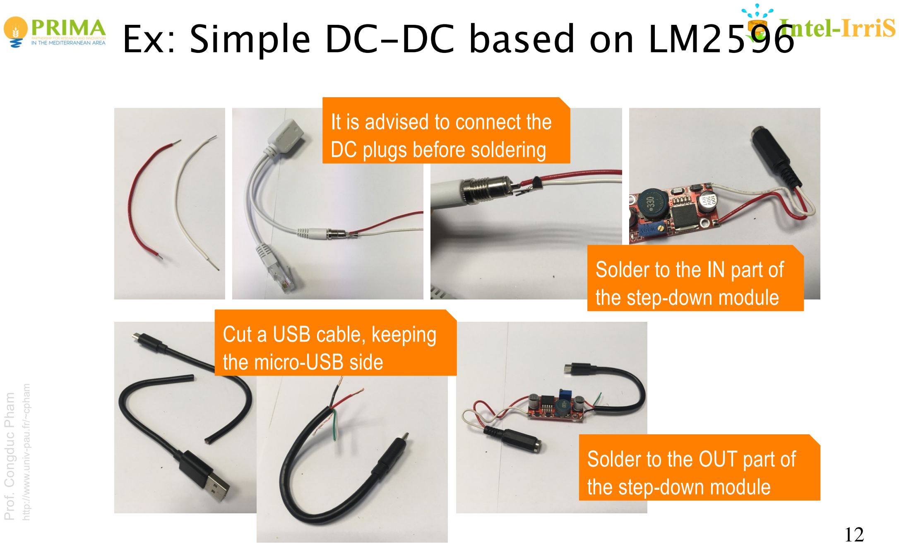
[picture p82: page 12]

12

Prof. Congduc Pham

http://www.univ-pau.fr/~cpham

## It is advised to connect the DC plugs before soldering

## Solder to the IN part of the step-down module Cut a USB cable, keeping the micro-USB side

## Solder to the OUT part of the step-down module

13

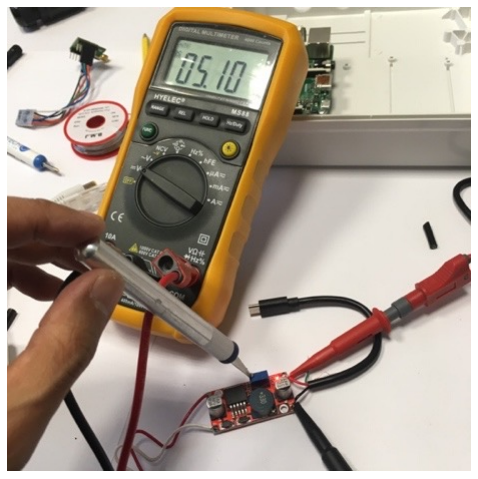
[picture p83: figure]
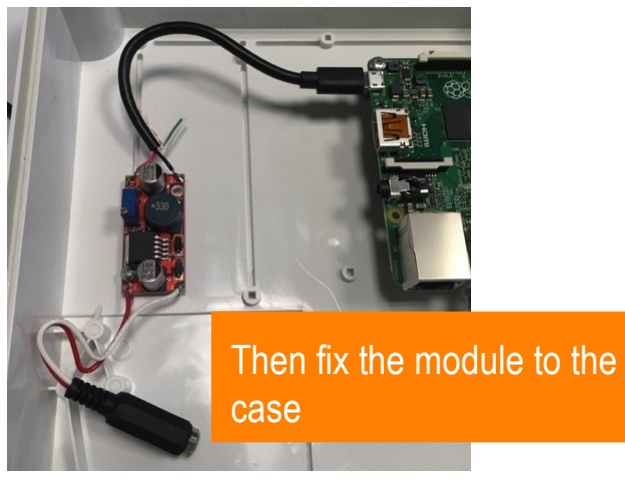
[picture p84: figure]
Then fix the module to the case

Prof. Congduc Pham

http://www.univ-pau.fr/~cpham

# Setting the step-down module

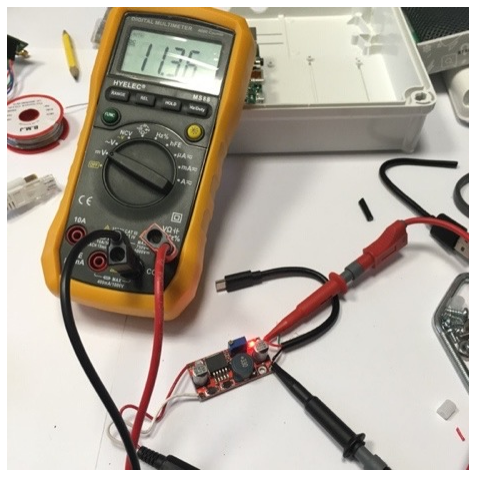
[picture p85: figure]

Use for instance a 9v, 12v or 18V AC-DC adaptor,
connect to the IN plug,
then check the output
voltage with a voltmeter
and turn the regulation
screw until output is about 5.1v.

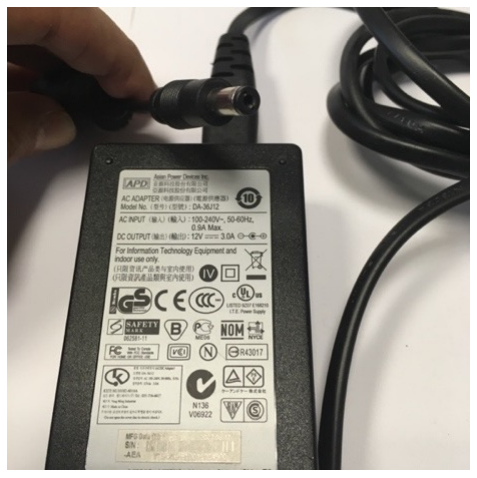
[picture p86: figure]
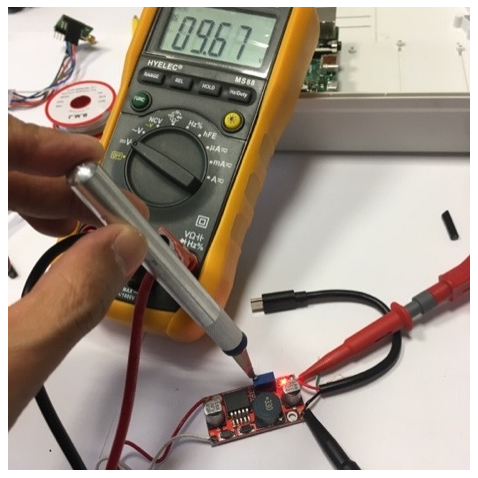
[picture p87: figure]

# Installing the PoE injector

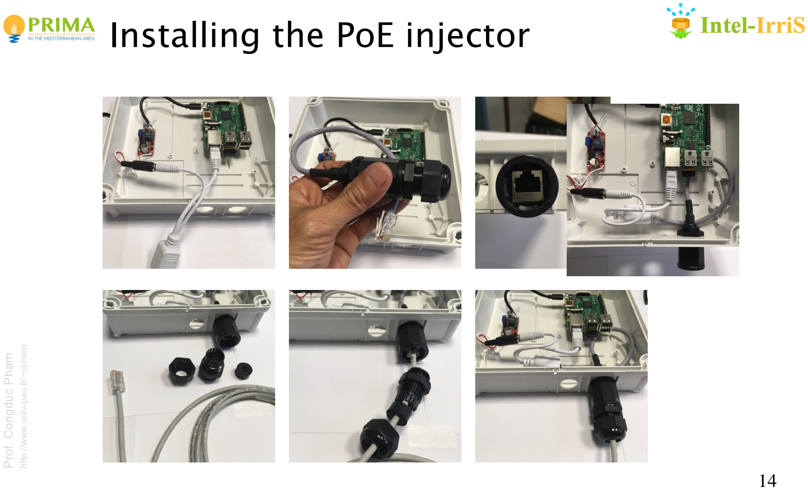
[picture p88: page 14]

14

Prof. Congduc Pham

http://www.univ-pau.fr/~cpham

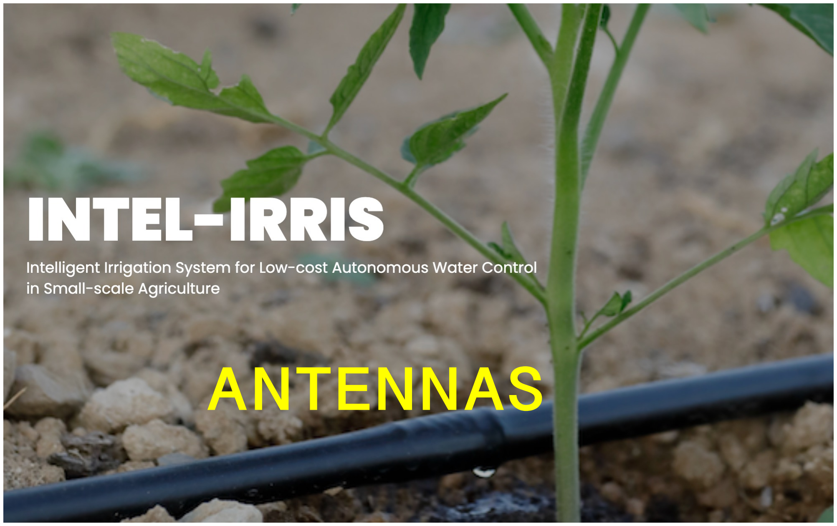
[picture p89: page 15]

# ANTENNAS

# Adding external antenna connector

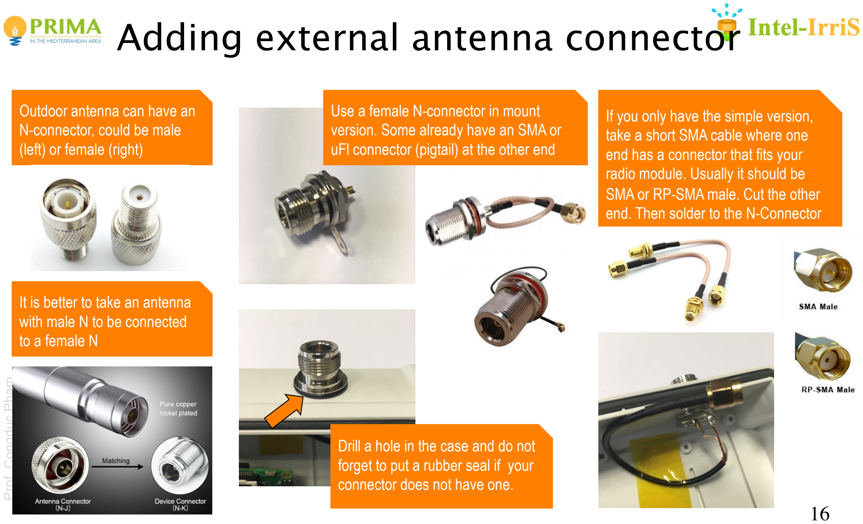
[picture p90: page 16]

16

Prof. Congduc Pham

http://www.univ-pau.fr/~cpham

If you only have the simple version, take a short SMA cable where one end has a connector that fits your radio module. Usually it should be SMA or RP-SMA male. Cut the other end. Then solder to the N-Connector

Drill a hole in the case and do not forget to put a rubber seal if your connector does not have one.

Use a female N-connector in mount version. Some already have an SMA or uFl connector (pigtail) at the other end

Outdoor antenna can have an N-connector, could be male (left) or female (right)

It is better to take an antenna with male N to be connected to a female N

17

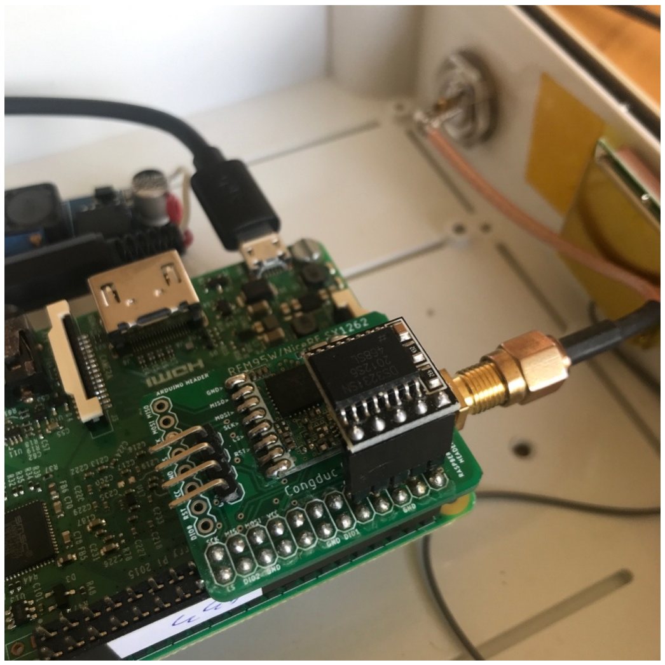
[picture p91: figure]

Prof. Congduc Pham

http://www.univ-pau.fr/~cpham

# Installing & connecting the LoRa hat

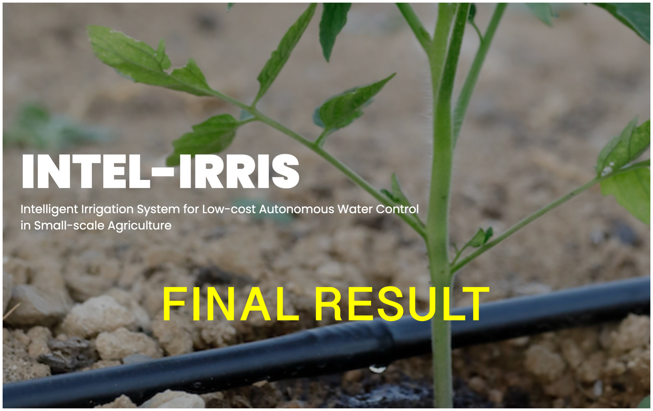
[picture p92: page 18]

# FINAL RESULT

# Install fixing parts of the case

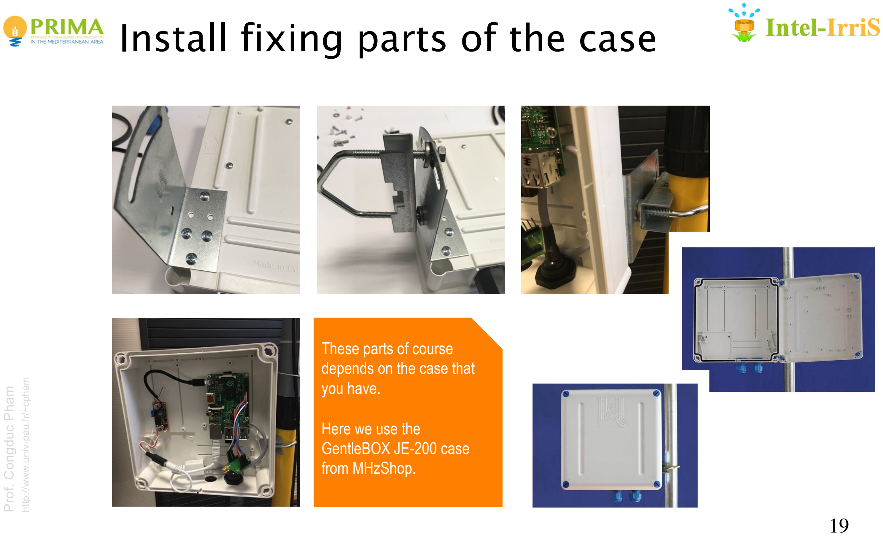
[picture p93: page 19]

19

Prof. Congduc Pham

http://www.univ-pau.fr/~cpham

These parts of course
depends on the case that
you have.

Here we use the
GentleBOX JE-200 case
from MHzShop.

# Final result

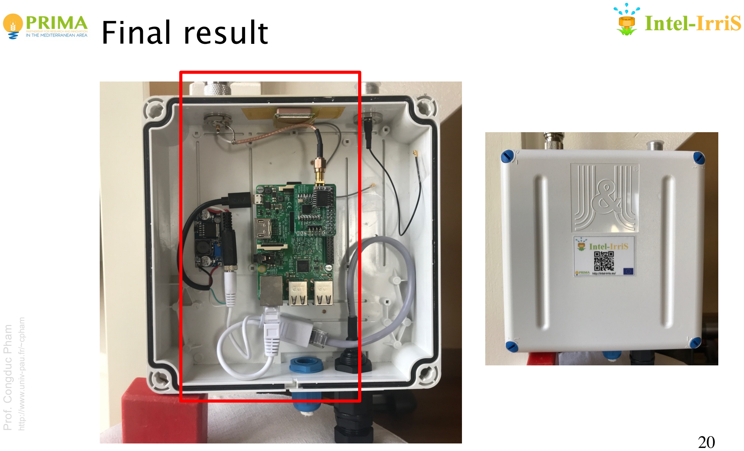
[picture p94: page 20]

20

Prof. Congduc Pham

http://www.univ-pau.fr/~cpham

21

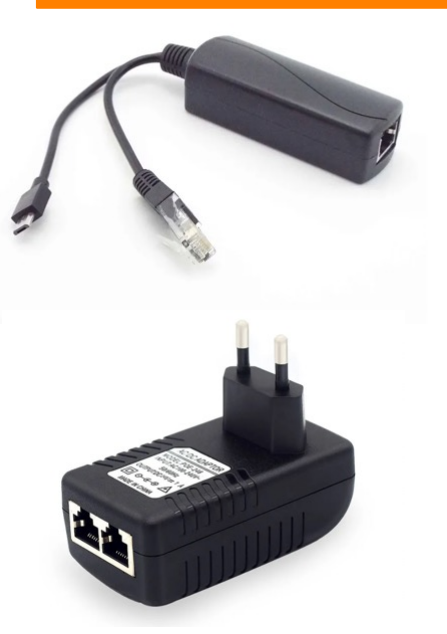
[picture p95: figure]
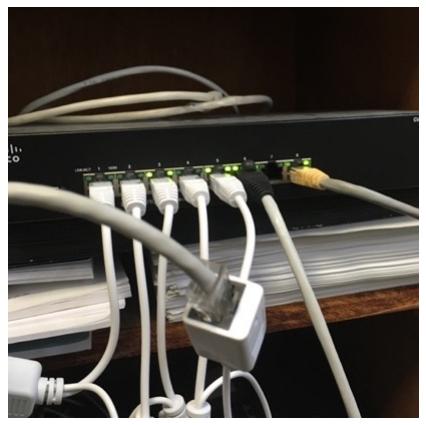
[picture p96: figure]
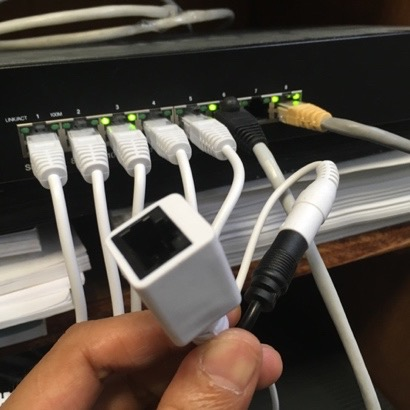
[picture p97: figure]

Prof. Congduc Pham

http://www.univ-pau.fr/~cpham

# Connect to Internet

## With PoE adaptor or PoE switch

## Without PoE switch, use an AC-DC 9V-24V adaptor

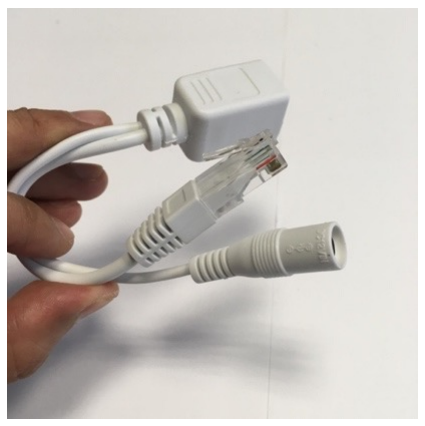
[picture p98: figure]
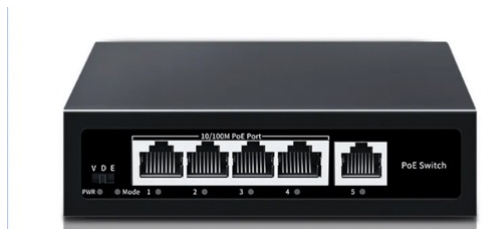
[picture p99: figure]
