CongducPham/PRIMA-Intel-IrriS/Tutorials/Intel-Irris-IIWA.pdf

1

Prof. Congduc Pham

http://www.univ-pau.fr/~cpham

## Intelligent Irrigation System for Low-cost Autonomous Water Control in Small-scale Agriculture

# Building the INTEL-IRRIS LoRa IoT platform Part 4: the INTEL-IRRIS Irrigation WaziApp

IoT – from idea to reality

Prof. Congduc Pham
http://www.univ-pau.fr/~cpham Université de Pau, France

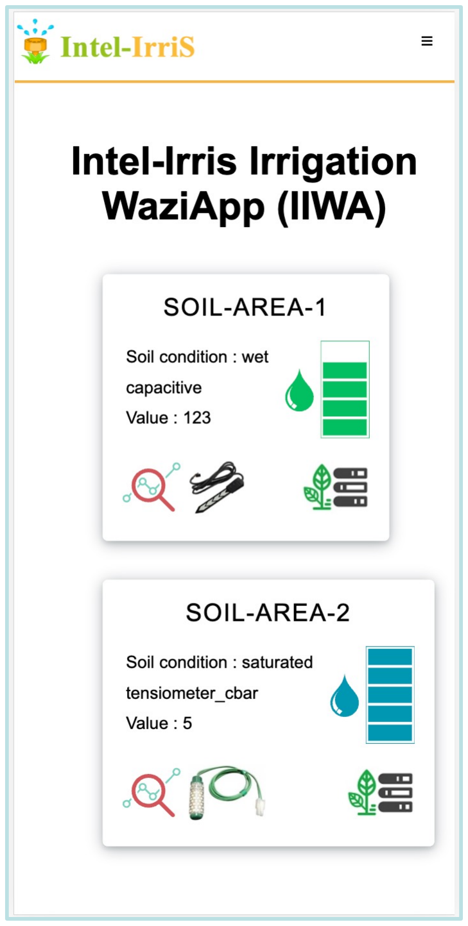
[picture p100: figure]
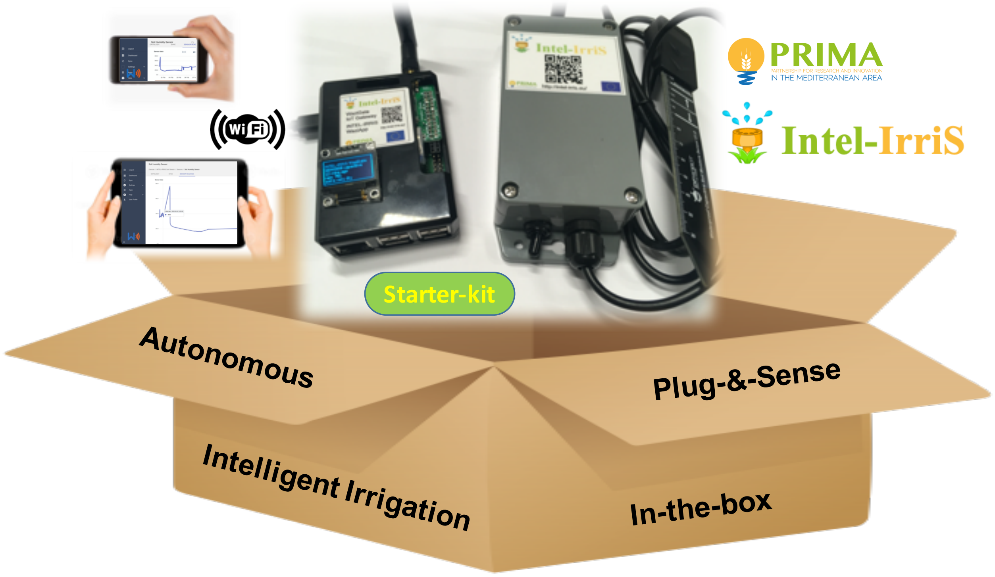
[picture p101: figure]
Starter-kit

3

Prof. Congduc Pham

http://www.univ-pau.fr/~cpham

## INTEL-IRRIS Irrigation WaziApp

⊙ The INTEL-IRRIS Irrigation WaziApp (IIWA) is an embedded application running on the INTEL-IRRIS gateway itself
⊙ It is included in the starter-kit to implement the "intelligent Irrigation in-the-box" & "plug-&-sense" approach
⊙ Its objective is to enhance the irrigation indication by applying sensor calibration models with soil/plant/weather parameters

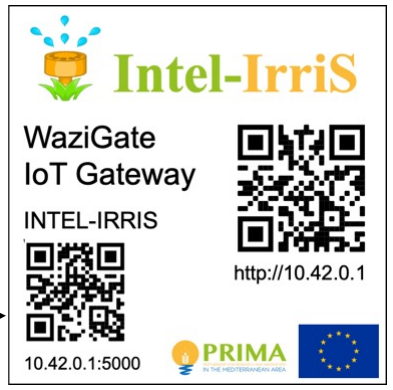
[picture p102: figure]
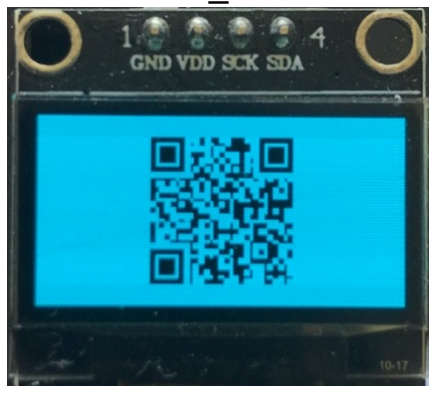
[picture p103: figure]

4

Prof. Congduc Pham

http://www.univ-pau.fr/~cpham

## Connect to IIWA

⊙ First, connect to INTEL-IRRIS gateway WiFi which should look like WAZIGATE_XXXXXXXXXXXX
⊙ Password is loragateway
⊙ Otherwise, with the OLED screen, a QR code for automatically joining the WiFi network is periodically displayed for 10s
⊙ scan the displayed QR code with a smartphone to connect to gateway's WiFi
⊙ Then, scan the static QR code on the gateway sticker to connect to the INTEL-IRRIS Irrigation WaziApp on : http://10.42.0.1:5000

WAZIGATE_DCA6325C2A7A

## IIWA main screens

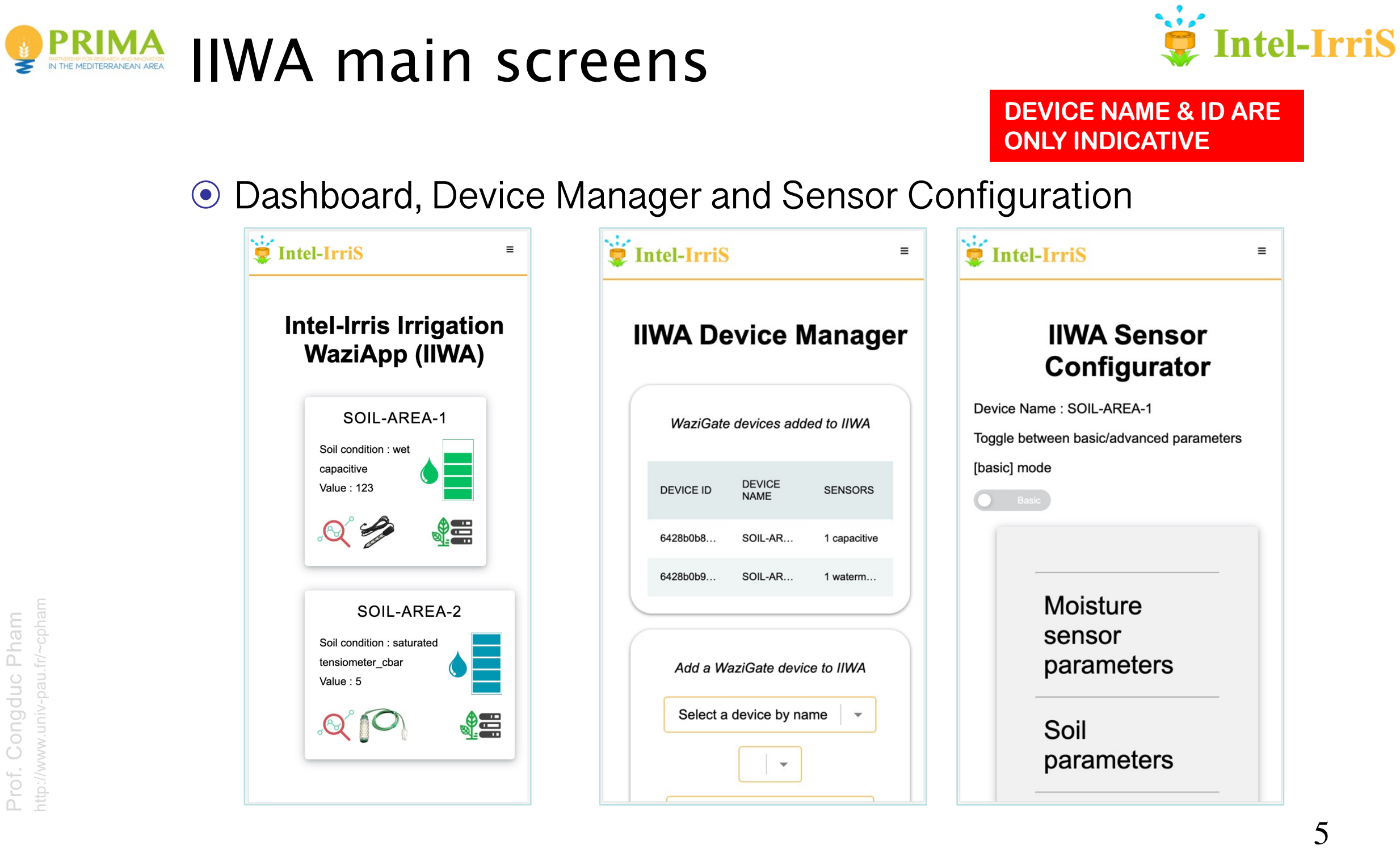
[picture p104: page 5]

5

Prof. Congduc Pham

http://www.univ-pau.fr/~cpham

⊙ Dashboard, Device Manager and Sensor Configuration

DEVICE NAME & ID ARE
ONLY INDICATIVE

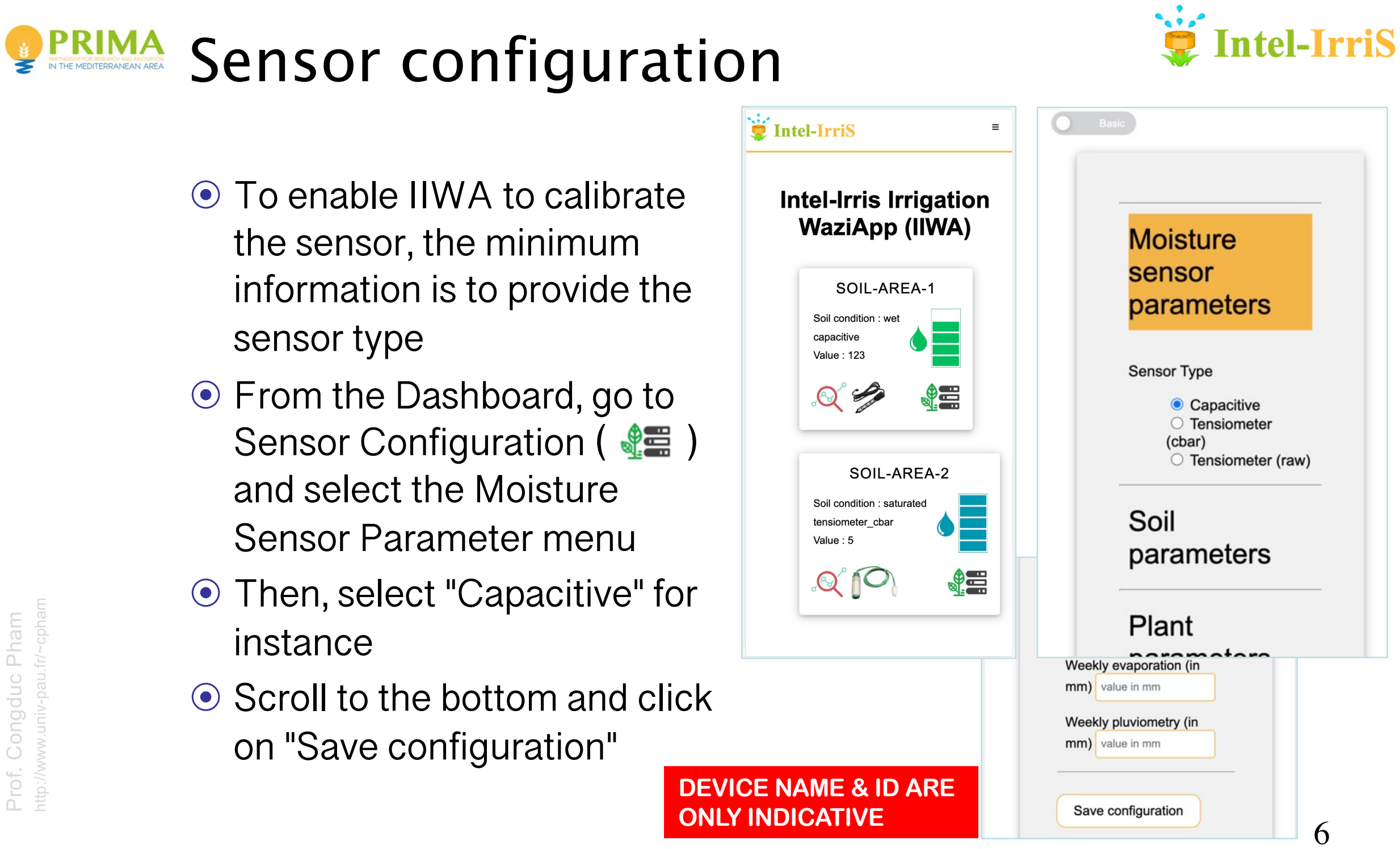
[picture p105: page 6]

6

Prof. Congduc Pham

http://www.univ-pau.fr/~cpham

Sensor configuration ⊙ To enable IIWA to calibrate

the sensor, the minimum
information is to provide the sensor type
⊙ From the Dashboard, go to Sensor Configuration ( )
and select the Moisture
Sensor Parameter menu
⊙ Then, select "Capacitive" for instance
⊙ Scroll to the bottom and click on "Save configuration"
| DEVICE NAME & ID ARE ONLY INDICATIVE

## List of advanced parameters

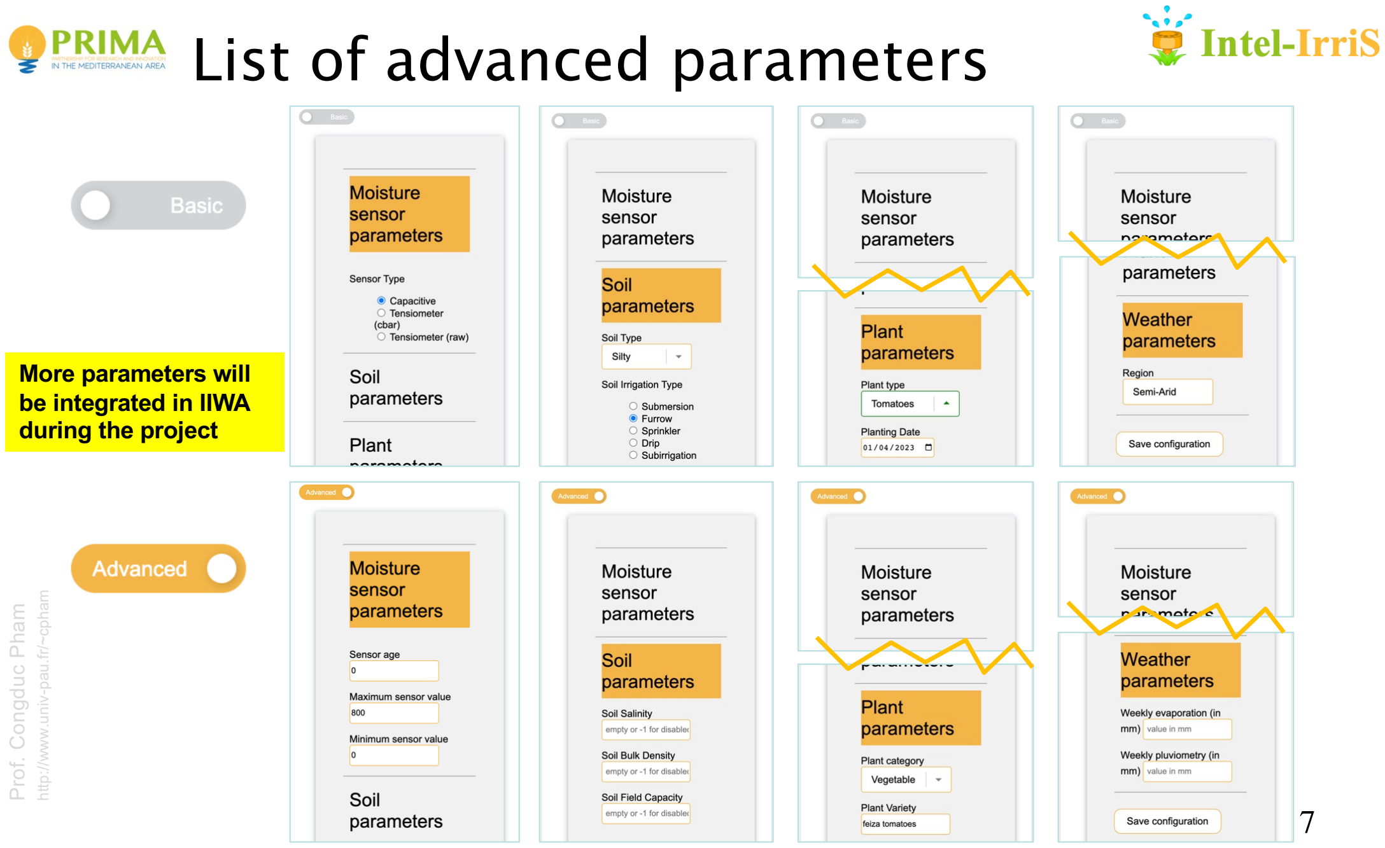
[picture p106: page 7]

7

Prof. Congduc Pham

http://www.univ-pau.fr/~cpham

More parameters will
be integrated in IIWA
during the project

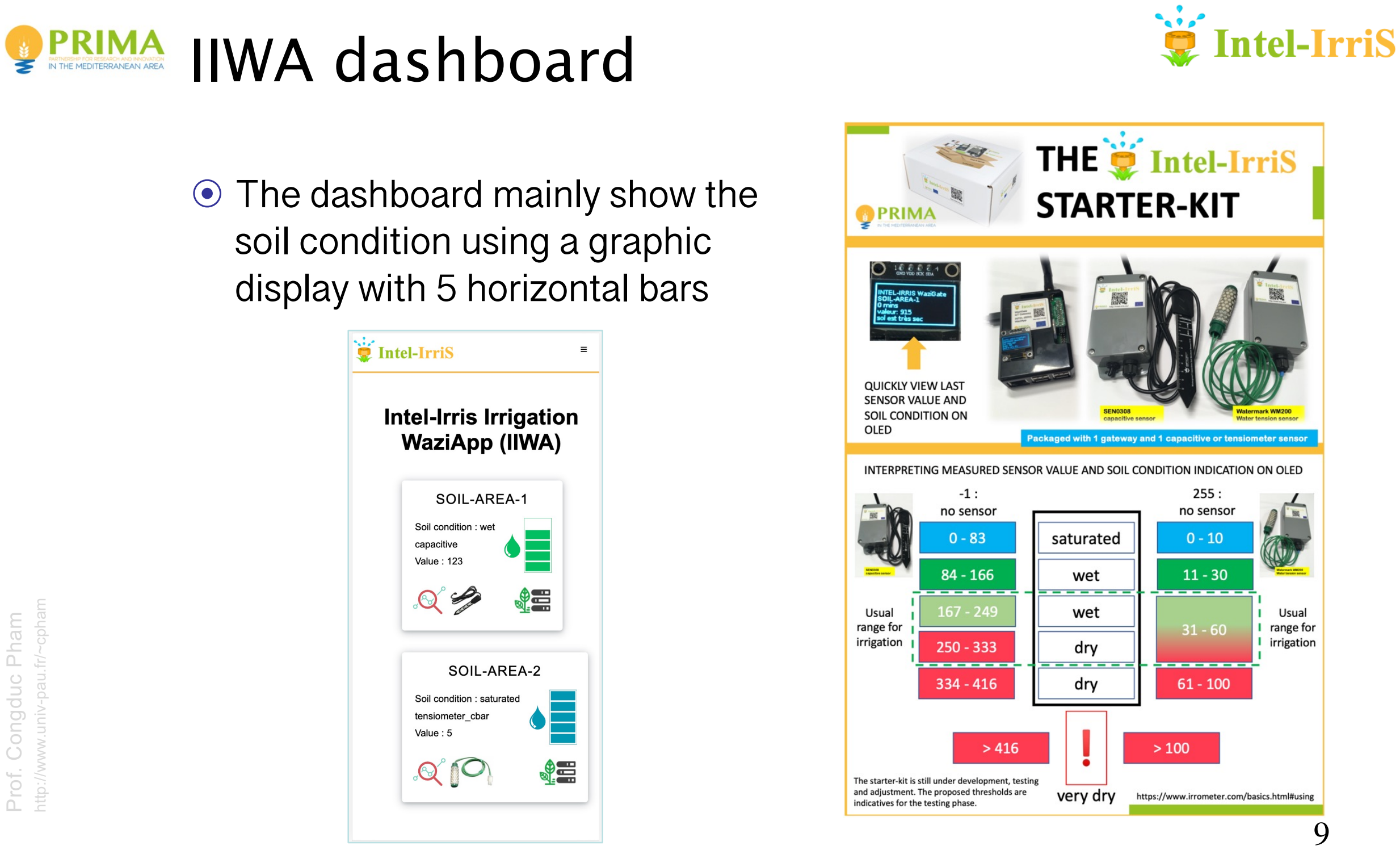
[picture p107: page 8]

9

Prof. Congduc Pham

http://www.univ-pau.fr/~cpham

IIWA dashboard ⊙ The dashboard mainly show the

soil condition using a graphic display with 5 horizontal bars

## First IIWA demo at Mostaganem event

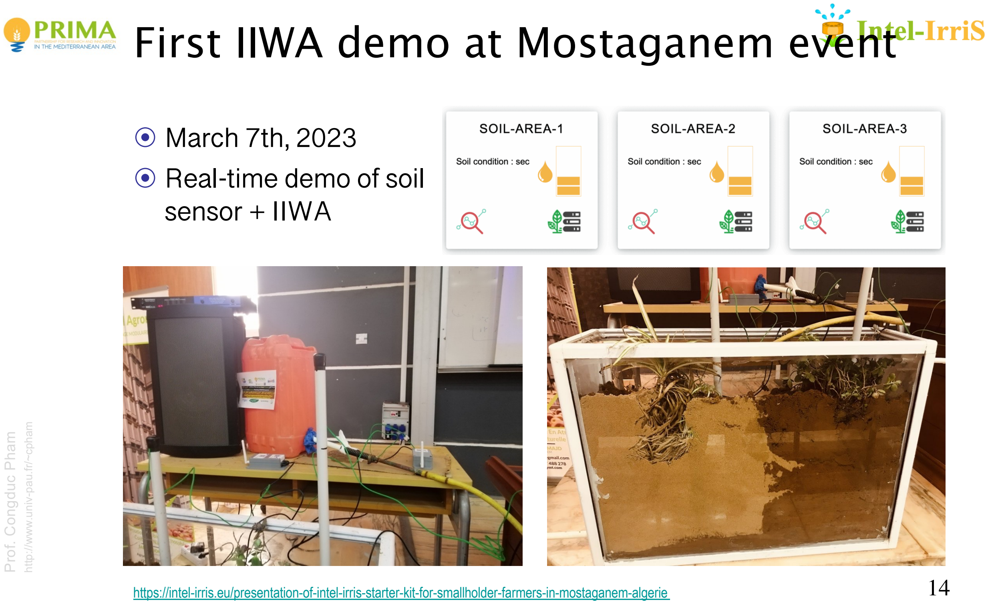
[picture p108: page 9]

14

Prof. Congduc Pham

http://www.univ-pau.fr/~cpham

⊙ March 7th, 2023
⊙ Real-time demo of soil
sensor + IIWA

https://intel-irris.eu/presentation-of-intel-irris-starter-kit-for-smallholder-farmers-in-mostaganem-algerie

15

Prof. Congduc Pham

http://www.univ-pau.fr/~cpham

## Indication on the OLED screen

⊙ IIWA monitors devices that are added to the IIWA application and only process sensor data from sensors that have been configured – i.e. at least the sensor type must be selected
⊙ When the device/sensor has been properly
configured then "IIWA" text is shown on the
summary screen associated to the device
⊙ If the irrigation indication computed by IIWA is older than the received time of the last value from the device then "IIWA" text will not show

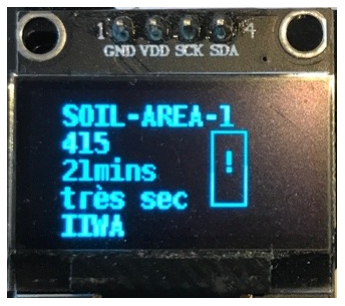
[picture p109: figure]
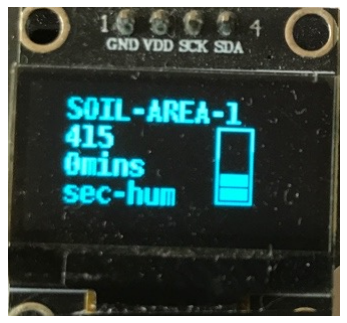
[picture p110: figure]

anymore, indicating that the irrigation indication
may not be accurate
⊙ This can happen if IIWA application is not running for some reasons. In this case, try to reboot the INTEL-IRRIS gateway if you are sure that device/sensor configuration has been performed properly

IIWA is active.
Irrigation indication
"très sec" (very dry)
reflects the soil
condition

IIWA is NOT active.
Irrigation indication
"sec-hum" (dry-wet)
does not reflect
correctly the soil
condition as sensor
type and soil type are
not taken into account
