CongducPham/PRIMA-Intel-IrriS/Tutorials/Intel-Irris-starter-kit-flyer-en.pdf

# THE STARTER-KIT

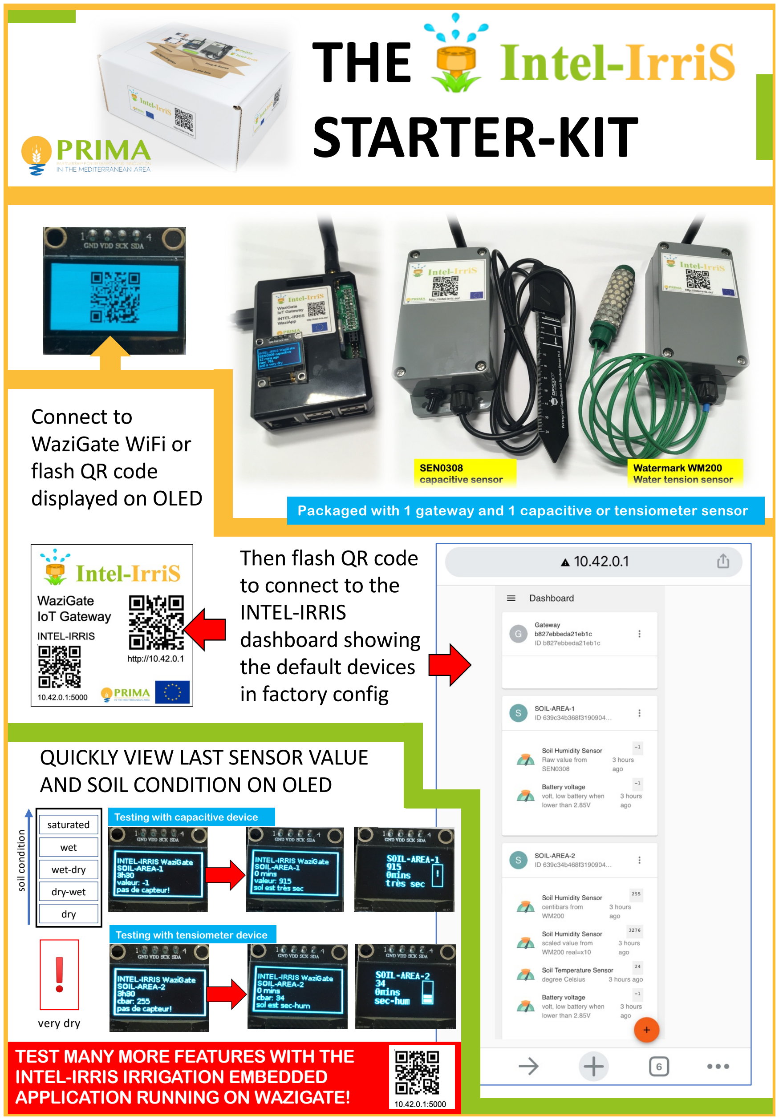
[picture p111: page 1]

Connect to
WaziGate WiFi or
flash QR code
displayed on OLED

Then flash QR code
to connect to the
INTEL-IRRIS
dashboard showing
the default devices
in factory config

QUICKLY VIEW LAST SENSOR VALUE AND SOIL CONDITION ON OLED

TEST MANY MORE FEATURES WITH THE INTEL-IRRIS IRRIGATION EMBEDDED APPLICATION RUNNING ON WAZIGATE!

Testing with capacitive device

Testing with tensiometer device

dry-wet

wet-dry

wet

saturated

dry

very dry

soil condition

Packaged with 1 gateway and 1 capacitive or tensiometer sensor
