CongducPham/PRIMA-Intel-IrriS/Tutorials/Intel-Irris-starter-kit-flyer-fr.pdf

# LE STARTER-KIT

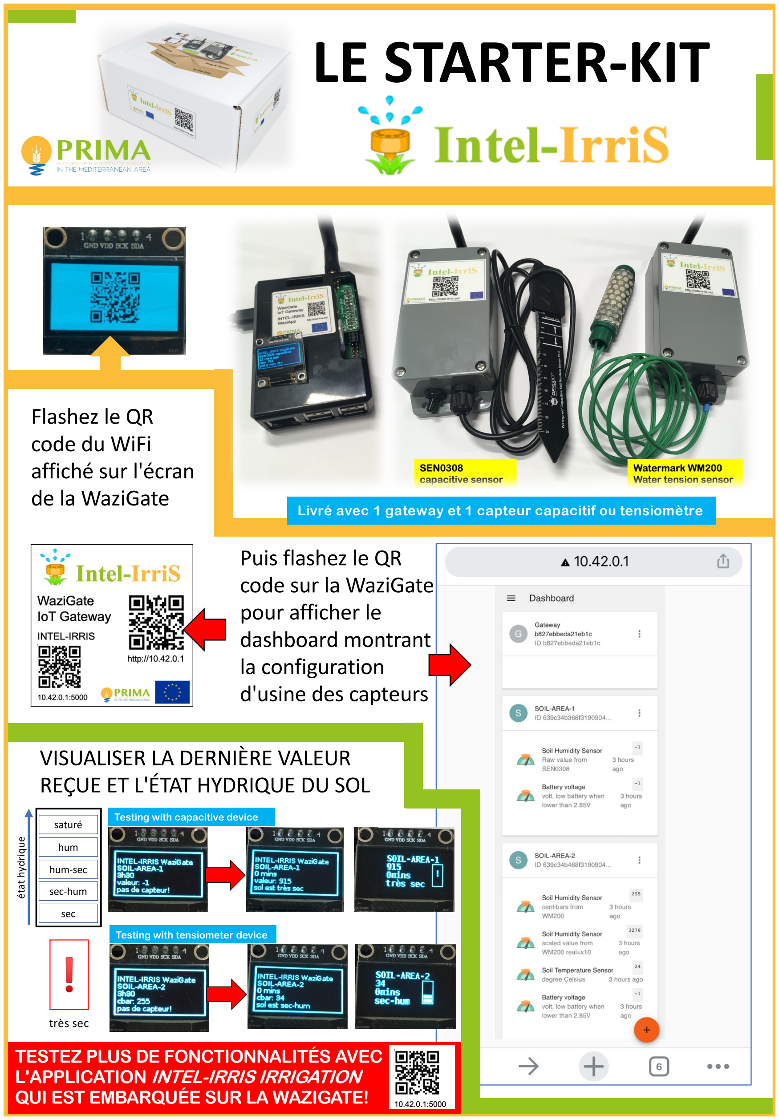
[picture p112: page 1]

Flashez le QR
code du WiFi
affiché sur l'écran
de la WaziGate

Puis flashez le QR
code sur la WaziGate
pour afficher le
dashboard montrant
la configuration
d'usine des capteurs

VISUALISER LA DERNIÈRE VALEUR REÇUE ET L'ÉTAT HYDRIQUE DU SOL

TESTEZ PLUS DE FONCTIONNALITÉS AVEC L'APPLICATION INTEL-IRRIS IRRIGATION QUI EST EMBARQUÉE SUR LA WAZIGATE!

Testing with capacitive device

Testing with tensiometer device

très sec

sec-hum

hum-sec

hum

saturé

sec

état hydrique

Livré avec 1 gateway et 1 capteur capacitif ou tensiomètre
