CongducPham/PRIMA-Intel-IrriS/Tutorials/Intel-Irris-antenna-test.pdf

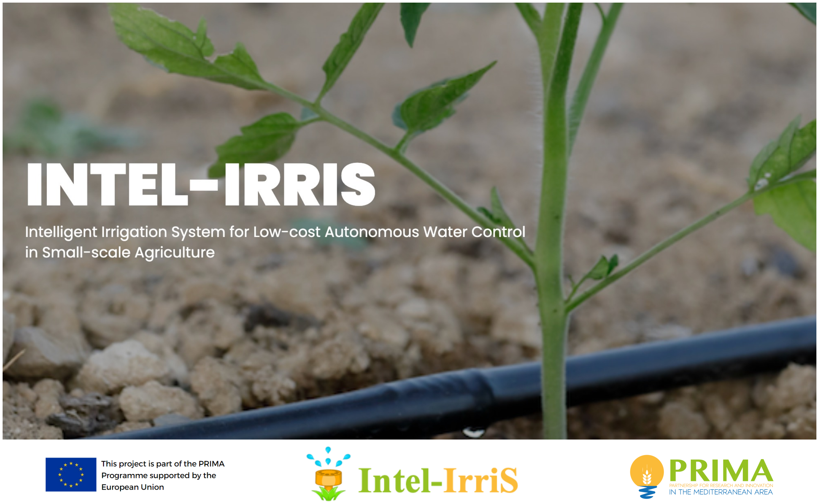
[picture p113: page 1]

## Intelligent Irrigation System for Low-cost Autonomous Water Control in Small-scale Agriculture

# Building the INTEL-IRRIS IoT platform Annex-2: antenna tests

IoT – from idea to reality

Prof. Congduc Pham
http://www.univ-pau.fr/~cpham Université de Pau, France

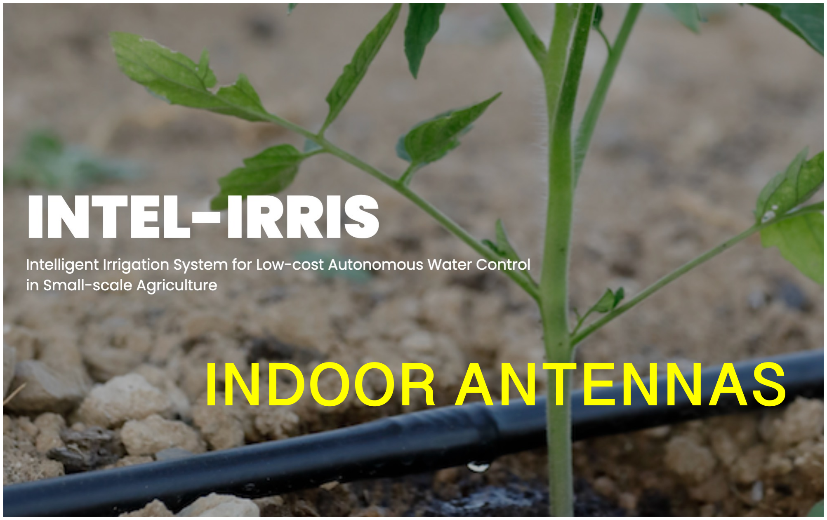
[picture p114: page 3]

# INDOOR ANTENNAS

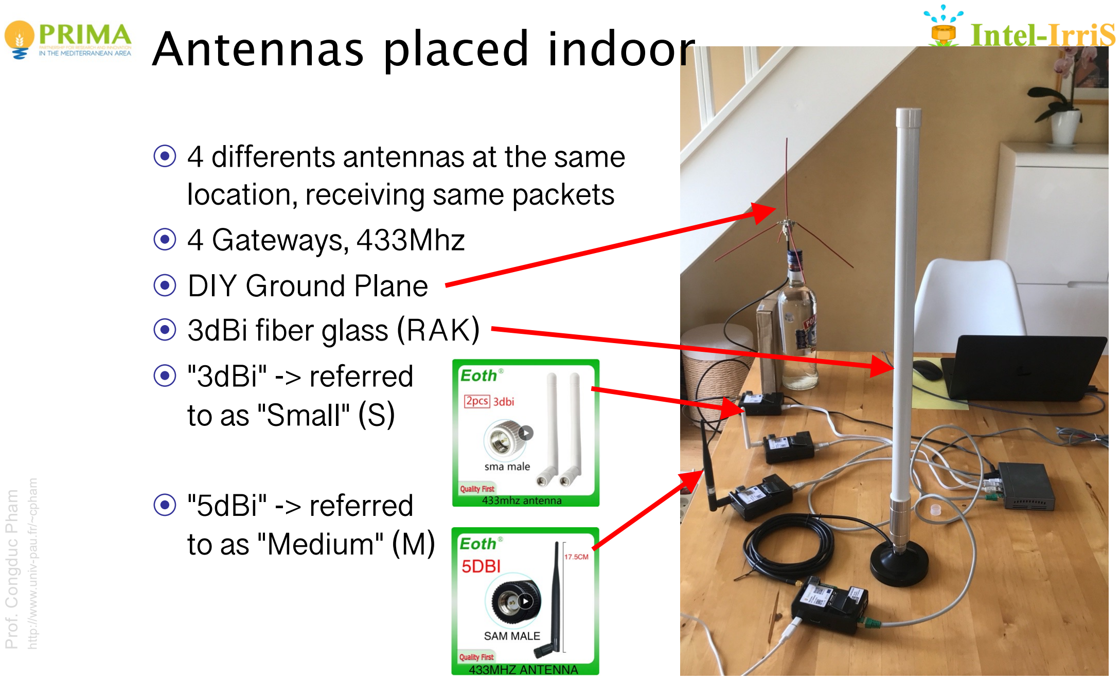
[picture p115: page 4]

4

Prof. Congduc Pham

http://www.univ-pau.fr/~cpham

Antennas placed indoor ⊙ 4 differents antennas at the same

location, receiving same packets
⊙ 4 Gateways, 433Mhz ⊙ DIY Ground Plane ⊙ 3dBi fiber glass (RAK) ⊙ "3dBi" -> referred

to as "Small" (S)

⊙ "5dBi"
-> referred
to as "Medium" (M)

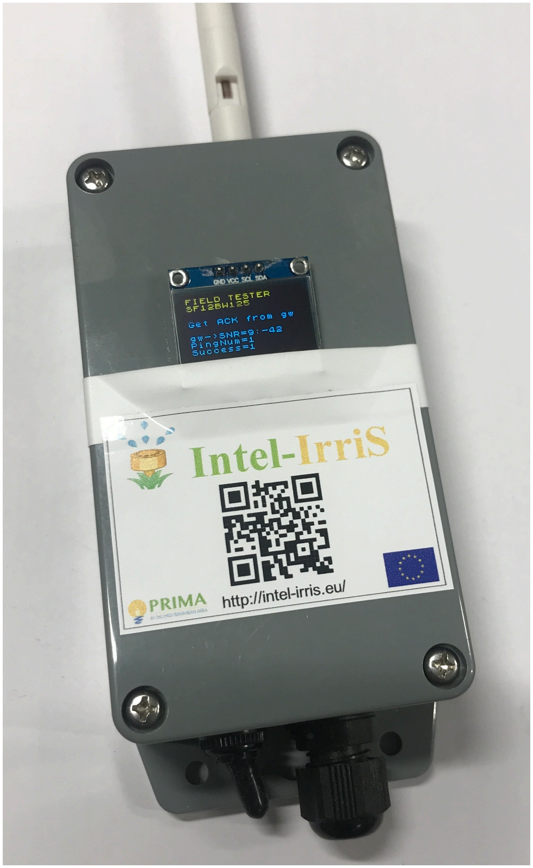
[picture p116: figure]
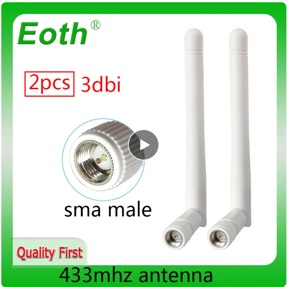
[picture p117: figure]

5

Prof. Congduc Pham

http://www.univ-pau.fr/~cpham

Transmitter device (1) ⊙ We use the Field Tester device

but we did not expect any
correct acknowledgment from gateways as since there are 4 gateways, their ACKs will most probably collide and interfere each other
⊙ The transmitter antenna is the "Small" one

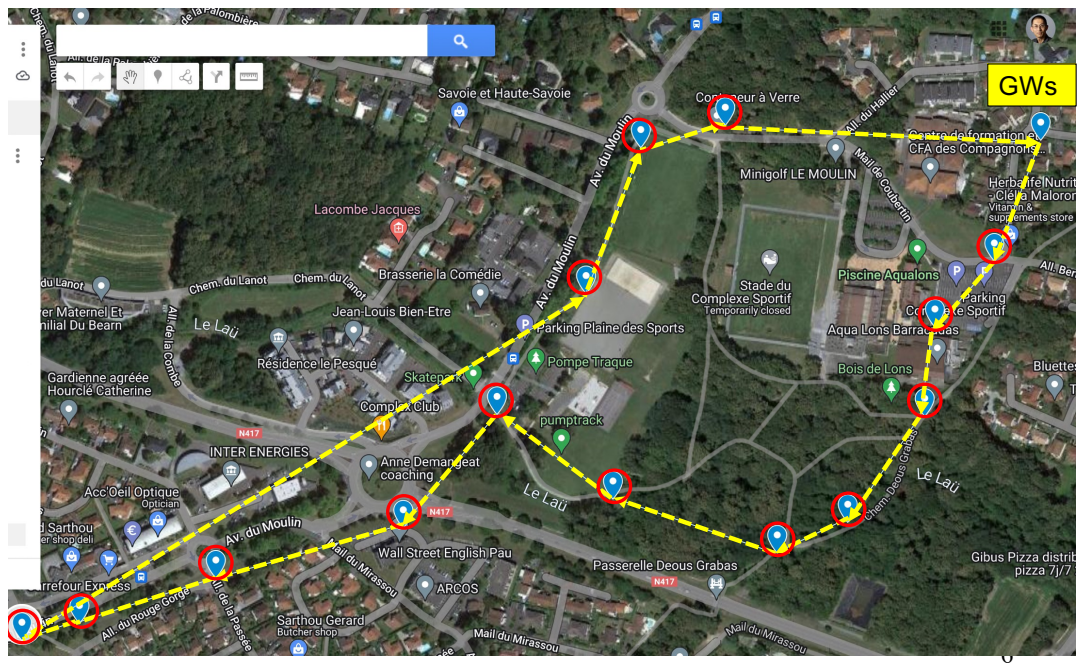
[picture p118: page 6]
GWs

http://www.univ-pau.fr/~cpham

Prof. Congduc Pham

7

Prof. Congduc Pham

http://www.univ-pau.fr/~cpham

GWs

RAK | M | S | GP
6/
-83. | 5/
| -87 | 2/
-116 | 6/
| | | -95
| | | 120m

200

m

RAK | M | S | GP 6/-91 | 3/-95 | N/A | 6/-97

280

m

RAK | M | S | GP 4/-106 | -5/-105 | -17/-126 | 5/-104
RAK | M | S | GP
SNR/RSSI SNR/RSSI SNR/RSSI | SNR/RSSI

8

Prof. Congduc Pham

http://www.univ-pau.fr/~cpham

GWs

RAK | M | S | GP
3/-110 | -16/-109 N/A | -6/-120
| | | 400m

460m

RAK | M | S | GP
-8/-121 N/A | N/A | -12/-121

520m

RAK | M | S | GP
-1/-117 N/A | N/A | -11/-120
RAK | M | S | GP
SNR/RSSI SNR/RSSI SNR/RSSI | SNR/RSSI

9

Prof. Congduc Pham

http://www.univ-pau.fr/~cpham

GWs

RAK | M | S | GP
-2/-112 -15/-108 N/A | -5/-118
| | | 570m

700m

RAK | M | S | GP
-8/-121 N/A | N/A | -12/-121

875m

RAK | M | S | GP
-9/-120 N/A | N/A | -2/-116
RAK | M | S | GP
SNR/RSSI SNR/RSSI SNR/RSSI | SNR/RSSI

10

Prof. Congduc Pham

http://www.univ-pau.fr/~cpham

GWs

1060m

RAK | M | S | GP
N/A | N/A | N/A | N/A

1000m

RAK | M | S | GP
-17/-123 N/A | N/A | -20/-123
RAK | M | S | GP
SNR/RSSI SNR/RSSI SNR/RSSI | SNR/RSSI

11

Prof. Congduc Pham

http://www.univ-pau.fr/~cpham

GWs

RAK | M | S | GP
5/-100 | -10/-104 -125/-123 6/-96
| | | 300m

450m

RAK | M | S | GP
0/-116 | N/A | N/A | 1/-114

375m

RAK | M | S | GP
0/-116 | -18/-109 N/A | -9/-119
RAK | M | S | GP
SNR/RSSI SNR/RSSI SNR/RSSI | SNR/RSSI

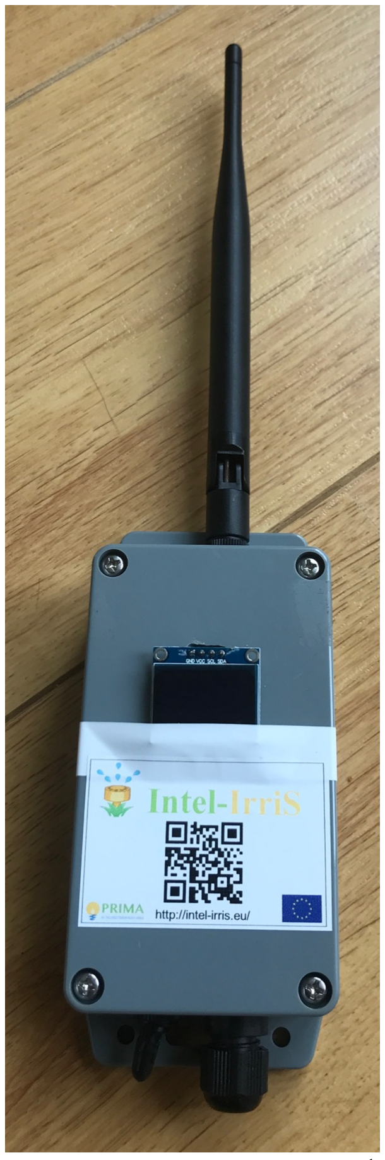
[picture p119: figure]
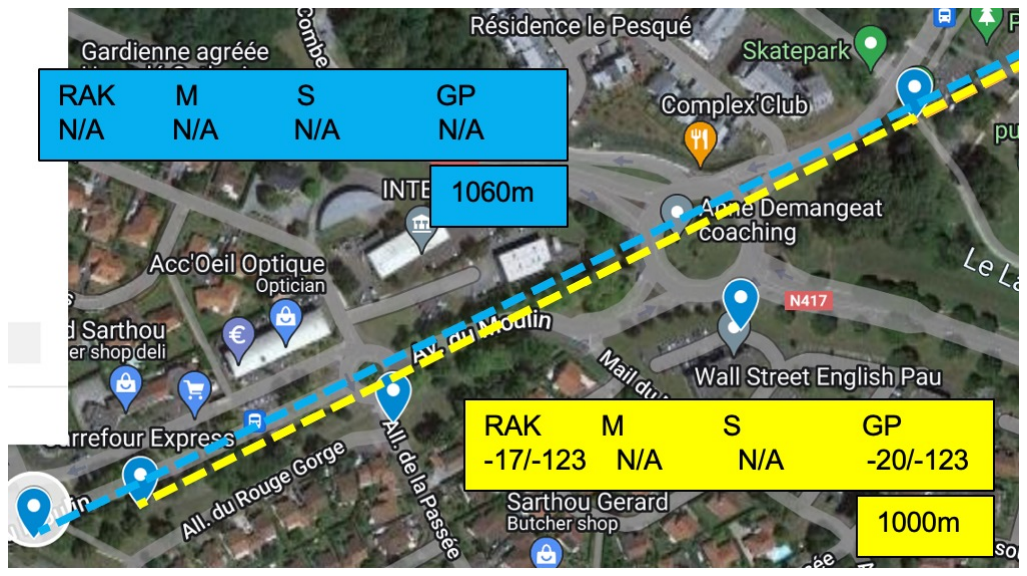
[picture p120: figure]

12

Prof. Congduc Pham

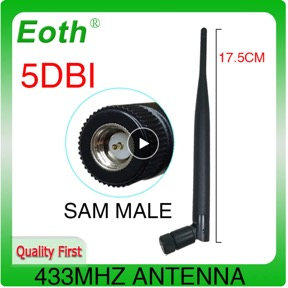
[picture p121: figure]

http://www.univ-pau.fr/~cpham

Transmitter device (2) ⊙ We use the Field Tester device

with the medium antenna to see if this would improve
transmission & reception
⊙ The transmitter antenna is now the "Medium" one
⊙ We start at the position where no reception were received (blue)

13

Prof. Congduc Pham

http://www.univ-pau.fr/~cpham

GWs

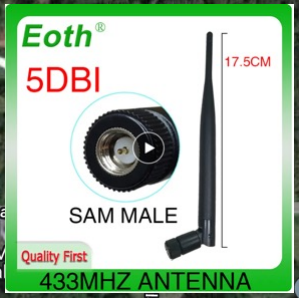
[picture p122: figure]

1060m

RAK | M | S | GP
-20/-123 N/A | N/A | -21/-124

1000m

RAK | M | S | GP
-17/-123 N/A | N/A. | N/A
RAK | M | S | GP
SNR/RSSI SNR/RSSI SNR/RSSI | SNR/RSSI

With the "Medium" antenna, some packets have been received at the limit of LoRa's sensitivity.

At the yellow position, the previous experiment with the "Small" antenna gave the same SNR.

In conclusion, the "Medium" antenna on the device can only improve by a bit the reception.

We believe it is not worth having "Medium" or bigger antenna at device side.

14

Prof. Congduc Pham

http://www.univ-pau.fr/~cpham

## Conclusions on indoor antennas

⊙ The small "3dBi" has limit at about 300m
⊙ The medium "5dBi" has limit at about 400m, if less obstacle it can probably receive at 600m
⊙ The RAK fiber glass & DIY GP has limit at about 1km
⊙ The RAK fiber glass is more performant than the DIY GP but costs about 30€, with the base, it is about 50€
⊙ The DIY GP costs about 10€ with the extension cable SMA male-> N-male. The DIY GP is quite good actually!
⊙ In typical agriculture fields, with less obstacle, we could probably add 300m to 500m to all the reached distances
⊙ Having "bigger" antenna at device side is not really interesting, it is probably better to put gateway's antenna in higher position
⊙ Having the gateway's antenna outdoor, at 3m height, in typical agriculture fields, can probably add an extra 1km!
