CongducPham/PRIMA-Intel-IrriS/Arduino/Intelirris_Soil_Sensor/local_lorawan.cpp

/*
 *  simple lorawan lib to encode and decode lorawan packet
 *  
 *  Copyright (C) 2016-2024 Congduc Pham, University of Pau, France
 *
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
 *****************************************************************************/
 
#include "local_lorawan.h"

// we wrapped Serial.println to support the Arduino Zero or M0
#if defined __SAMD21G18A__ && not defined ARDUINO_SAMD_FEATHER_M0
#define PRINTLN                   SerialUSB.println("")              
#define PRINT_CSTSTR(param)       SerialUSB.print(F(param))
#define PRINT_STR(fmt,param)      SerialUSB.print(param)
#define PRINT_VALUE(fmt,param)    SerialUSB.print(param)
#define PRINT_HEX(fmt,param)      SerialUSB.print(param,HEX)
#define FLUSHOUTPUT               SerialUSB.flush()
#else
#define PRINTLN                   Serial.println("")
#define PRINT_CSTSTR(param)       Serial.print(F(param))
#define PRINT_STR(fmt,param)      Serial.print(param)
#define PRINT_VALUE(fmt,param)    Serial.print(param)
#define PRINT_HEX(fmt,param)      Serial.print(param,HEX)
#define FLUSHOUTPUT               Serial.flush()
#endif

///////////////////////////////////////////////////////////////////
//For TTN, use specify ABP mode on the TTN device setting

///////////////////////////////////////////////////////////////////
//ENTER HERE your App Session Key from the TTN device info (same order, i.e. msb)
//unsigned char AppSkey[16] = { 0x00, 0x00, 0x00, 0x00, 0x00, 0x00, 0x00, 0x00, 0x00, 0x00, 0x00, 0x00, 0x00, 0x00, 0x00, 0x00 };
///////////////////////////////////////////////////////////////////

//Pau
//0540AC07B09E0C60650D50CF00F01C0D
//unsigned char AppSkey[16] = { 0x05, 0x40, 0xAC, 0x07, 0xB0, 0x9E, 0x0C, 0x60, 0x65, 0x0D, 0x50, 0xCF, 0x00, 0xF0, 0x1C, 0x0D };

//WaziGate default
//23158D3BBC31E6AF670D195B5AED5525
unsigned char AppSkey[16] = {0x23, 0x15, 0x8D, 0x3B, 0xBC, 0x31, 0xE6, 0xAF, 0x67, 0x0D, 0x19, 0x5B, 0x5A, 0xED, 0x55, 0x25};
//unsigned char AppSkey[16] = {0x23, 0x15, 0x8D, 0x3B, 0xBC, 0x31, 0xE6, 0xAF, 0x67, 0x0D, 0x19, 0x5B, 0x5A, 0xED, 0xAB, 0xCD};

//this is the default as LoRaWAN example
//unsigned char AppSkey[16] = { 0x2B, 0x7E, 0x15, 0x16, 0x28, 0xAE, 0xD2, 0xA6, 0xAB, 0xF7, 0x15, 0x88, 0x09, 0xCF, 0x4F, 0x3C };

///////////////////////////////////////////////////////////////////
//ENTER HERE your Network Session Key from the TTN device info (same order, i.e. msb)
//unsigned char NwkSkey[16] = { 0x00, 0x00, 0x00, 0x00, 0x00, 0x00, 0x00, 0x00, 0x00, 0x00, 0x00, 0x00, 0x00, 0x00, 0x00, 0x00 };
///////////////////////////////////////////////////////////////////

//Pau
//0110FF0060BA0AE00F0A606B0A508F01
//unsigned char NwkSkey[16] = { 0x01, 0x10, 0xFF, 0x00, 0x60, 0xBA, 0x0A, 0xE0, 0x0F, 0x0A, 0x60, 0x6B, 0x0A, 0x50, 0x8F, 0x01 };

//WaziGate default
//23158D3BBC31E6AF670D195B5AED5525
unsigned char NwkSkey[16] = {0x23, 0x15, 0x8D, 0x3B, 0xBC, 0x31, 0xE6, 0xAF, 0x67, 0x0D, 0x19, 0x5B, 0x5A, 0xED, 0x55, 0x25};
//unsigned char NwkSkey[16] = {0x23, 0x15, 0x8D, 0x3B, 0xBC, 0x31, 0xE6, 0xAF, 0x67, 0x0D, 0x19, 0x5B, 0x5A, 0xED, 0xAB, 0xCD};

//this is the default as LoRaWAN example
//unsigned char NwkSkey[16] = { 0x2B, 0x7E, 0x15, 0x16, 0x28, 0xAE, 0xD2, 0xA6, 0xAB, 0xF7, 0x15, 0x88, 0x09, 0xCF, 0x4F, 0x3C };

///////////////////////////////////////////////////////////////////
// DO NOT CHANGE HERE
uint16_t Frame_Counter_Up = 0x0000;
// 0 for uplink, 1 for downlink - See LoRaWAN specifications
unsigned char Direction = 0x00;
///////////////////////////////////////////////////////////////////

///////////////////////////////////////////////////////////////////
//create a LoRaWAN packet meaning that the payload is encrypted

void local_lorawan_init() {
  //avoid having exactely the same message in case of reboot when testing devices
  Frame_Counter_Up=analogRead(0) % 10;
  PRINT_CSTSTR("LoRaWAN: generating random frame counter up: ");
  PRINT_VALUE("%d", Frame_Counter_Up);
  PRINTLN;
}

///////////////////////////////////////////////////////////////////
//create a LoRaWAN packet meaning that the payload is encrypted

uint8_t local_aes_lorawan_create_pkt(uint8_t* message, uint8_t pl, uint8_t app_key_offset) {

      PRINT_STR("%s",(char*)(message+app_key_offset));
      PRINTLN;
      PRINT_CSTSTR("plain payload hex\n");
      for (int i=0; i<pl;i++) {
        if (message[i]<16)
          PRINT_CSTSTR("0");
        PRINT_HEX("%X", message[i]);
        PRINT_CSTSTR(" ");
      }
      PRINTLN; 

      PRINT_CSTSTR("Encrypting\n");     
      Encrypt_Payload((unsigned char*)message, pl, Frame_Counter_Up, Direction);

      PRINT_CSTSTR("encrypted payload\n");
      //Print encrypted message
      for (int i = 0; i < pl; i++)      
      {
        if (message[i]<16)
          PRINT_CSTSTR("0");
        PRINT_HEX("%X", message[i]);         
        PRINT_CSTSTR(" ");
      }
      PRINTLN;   

      // with only AES encryption, we still use a LoRaWAN packet format to reuse available LoRaWAN encryption libraries
      //
      unsigned char LORAWAN_Data[80];
      unsigned char LORAWAN_Package_Length;
      unsigned char MIC[4];
      //Unconfirmed data up
      unsigned char Mac_Header = 0x40;
      // no ADR, not an ACK and no options
      unsigned char Frame_Control = 0x00;
      // with application data so Frame_Port = 1..223
      unsigned char Frame_Port = 0x01; 

      //Build the Radio Package, LoRaWAN format
      //See LoRaWAN specification
      LORAWAN_Data[OFF_DAT_HDR] = Mac_Header;
    
      LORAWAN_Data[OFF_DAT_ADDR] = DevAddr[3];
      LORAWAN_Data[OFF_DAT_ADDR+1] = DevAddr[2];
      LORAWAN_Data[OFF_DAT_ADDR+2] = DevAddr[1];
      LORAWAN_Data[OFF_DAT_ADDR+3] = DevAddr[0];
    
      LORAWAN_Data[OFF_DAT_FCT] = Frame_Control;
    
      LORAWAN_Data[OFF_DAT_SEQNO] = (Frame_Counter_Up & 0x00FF);
      LORAWAN_Data[OFF_DAT_SEQNO+1] = ((Frame_Counter_Up >> 8) & 0x00FF);
    
      LORAWAN_Data[OFF_DAT_OPTS] = Frame_Port;
    
      //Set Current package length
      LORAWAN_Package_Length = OFF_DAT_OPTS+1;
      
      //Load Data
      for(int i = 0; i < pl; i++)
      {
        // see that we don't take the appkey, just the encrypted data that starts at message[app_key_offset]
        LORAWAN_Data[LORAWAN_Package_Length + i] = message[i];
      }
    
      //Add data Lenth to package length
      LORAWAN_Package_Length = LORAWAN_Package_Length + pl;
    
      PRINT_CSTSTR("calculate MIC with NwkSKey\n");
      //Calculate MIC
      Calculate_MIC(LORAWAN_Data, MIC, LORAWAN_Package_Length, Frame_Counter_Up, Direction);
    
      //Load MIC in package
      for (int i=0; i < 4; i++)
      {
        LORAWAN_Data[i + LORAWAN_Package_Length] = MIC[i];
      }
    
      //Add MIC length to package length
      LORAWAN_Package_Length = LORAWAN_Package_Length + 4;
    
      PRINT_CSTSTR("transmitted LoRaWAN-like packet:\n");
      PRINT_CSTSTR("MHDR[1] | DevAddr[4] | FCtrl[1] | FCnt[2] | FPort[1] | EncryptedPayload | MIC[4]\n");
      //Print transmitted data
      for (int i = 0; i < LORAWAN_Package_Length; i++)
      {
        if (LORAWAN_Data[i]<16)
          PRINT_CSTSTR("0");
        PRINT_HEX("%X", LORAWAN_Data[i]);         
        PRINT_CSTSTR(" ");
      }
      PRINTLN;      

      // copy back to message
      memcpy(message,LORAWAN_Data,LORAWAN_Package_Length);
      pl = LORAWAN_Package_Length;

#ifdef AES_SHOWB64
      //need to take into account the ending \0 for string in C
      int b64_encodedLen = base64_enc_len(pl)+1;
      char b64_encoded[b64_encodedLen];
               
      base64_encode(b64_encoded, (char*)message, pl);
      PRINT_CSTSTR("[base64 LoRaWAN HEADER+CIPHER+MIC]:");
      PRINT_STR("%s", b64_encoded);
      PRINTLN;
#endif      

      // in any case, we increment Frame_Counter_Up
      // even if the transmission will not succeed
      Frame_Counter_Up++;

      return pl;
}

///////////////////////////////////////////////////////////////////
//decode a LoRaWAN downlink packet and check the MIC

int8_t local_lorawan_decode_pkt(uint8_t* message, uint8_t pl) {

      unsigned char MIC[4];
      
      //get FCntDn from LoRaWAN downlink packet
      uint16_t seqno=(uint16_t)((uint16_t)message[OFF_DAT_SEQNO] | ((uint16_t)message[OFF_DAT_SEQNO+1]<<8));

      //end of payload, removing the 4-byte MIC
      uint8_t pend=pl-4;

      Calculate_MIC(message, MIC, pend, seqno, 1);

      if ((uint8_t)MIC[3]==message[pl-1] &&
          (uint8_t)MIC[2]==message[pl-2] &&
          (uint8_t)MIC[1]==message[pl-3] &&
          (uint8_t)MIC[0]==message[pl-4]) {

          PRINT_CSTSTR("Valid MIC\n");  
           
          //start of payload
          uint8_t poff=OFF_DAT_OPTS+1+(uint8_t)(message[OFF_DAT_FCT] & FCT_OPTLEN);
          
          //length of payload
          int8_t ml=pend-poff;
    
          if (ml>0) {
            PRINT_CSTSTR("Decrypting\n");          
            Encrypt_Payload((unsigned char*)(message+poff), ml, seqno, 1);
    
            PRINT_CSTSTR("clear payload\n"); 
            //Print decrypted message
            for (int i = poff; i < poff+ml; i++)      
            {
              if (message[i]<16)
                PRINT_CSTSTR("0");
              PRINT_HEX("%X", message[i]);         
              PRINT_CSTSTR(" ");
            }
            PRINTLN;
    
            return (int8_t)poff;
          }
          else
            PRINT_CSTSTR("No payload\n"); 
      }
      else 
        PRINT_CSTSTR("Bad MIC\n");
        
      return -1;              
}
