CongducPham/PRIMA-Intel-IrriS/Arduino/Arduino_LoRa_SX12XX_Ping_OLED/RadioSettings.h

///////////////////////////////////////////////////////////////////////////////////////////////////////////
// please uncomment only 1 choice 
//#define SX126X
#define SX127X
//#define SX128X
///////////////////////////////////////////////////////////////////////////////////////////////////////////
