CongducPham/PRIMA-Intel-IrriS/(commit log)

2021-11-14 Add ProMini PCBs
2021-11-16 Update PCBs, README and tutorials
2021-11-23 Update soil sensor code
2021-11-25 Update Arduino content
2021-11-30 Update Arduino code to better configure sensors
2022-01-20 Update PCB files
2022-02-27 Update tutorials and Arduino code
2022-03-11 Update Arduino and Tutorials
2022-03-16 Update tutorial and warmup time of sensor
2022-06-02 Update tutorials and Arduino code for Watermark
    [watermark.xlsx]
2022-06-03 Update Arduino code
2022-06-03 Update Arduino code for Watermark and OLED code
2022-06-10 Update Arduino code for Watermark
    [watermark.xlsx]
2022-06-20 Update Arduino code for wm+soil temperature
    [watermark.xlsx]
2022-06-21 Update BOM
2022-06-22 Update Arduino code for watermark and README
2022-06-27 Update watermark wiring
2022-07-01 Update wiring for temperature sensor
2022-07-03 add resistors in BOM
2022-07-28 fix bug for soil temperature
    [Intelirris_Soil_Sensor.ino]
2022-08-20 Update sketch & scripts for voltage monitoring, update device backup scripts
2022-08-20 Update voltage monitoring
2022-08-22 Update sketch for low voltage management
2022-08-25 Update for low-voltage
2022-09-07 Add sensor type in file name
2022-11-06 Update for WaziGate v2
    [intel-irris-auto-config-service.service.txt]
2022-11-29 No reboot after creation of new default device
2022-12-23 auto configuration: option to not delete devices
2022-12-25 add sensor data example samples
2023-01-30 Boot with a specified range of devices and their IIWA setup
2023-01-30 Boot with a specified set of devices and their IIWA setup
2023-02-05 Add crontab & scripts for sensor backup on USB stick
2023-02-08 update README for periodic sensor backup on USB stick
2023-03-06 Update for new IIWA device and config file names
2023-03-30 add template.csv for a plotting example
    [template.csv]
2023-03-31 config IIWA for 2_watermark devices
2023-03-31 update extract and plot scripts for 2-watermark devices
2023-03-31 gather timestamps for devices with asynchronous sensor values
2023-04-04 Update scripts for default temperature sensor w/capacitive device
2023-04-05 Add xlppChan meta field in sensor presets
2023-04-05 debug file path at boot and remove iiwa active device setup
2023-04-19 Generic Python data extractor, with device and sensor selection, and export to new Json format and Bondy's CSV format.
2023-05-03 Generic push feature, adds random values to all sensors
2023-05-09 update, backup and restore IIWA sensor configs
2023-05-10 python iiwa chunk update\n\n the update will merge the current config with the new loaded json string.
2023-05-11 Update sensor-backup/README.md, avoid overwriting USB contents
2023-05-15 Add a simple Field Tester device to facilitate deployment
2023-06-20 Update config_band.sh and IoT device tutorial
2023-06-28 Update tutorial for new PCB versions
2023-06-29 Update Arduino code for new PCB pinout & hardware list of parts
2023-09-21 Add new PCBs and update tutorials
2023-09-23 Update soil sensor code and PCBs description
    [watermark-caltable.xls, watermark.xlsx]
2023-09-28 Update tutorials for new PCBs and WaziSense v2
2023-10-13 Update for new IRD PCB and TTN upload for gateway
2023-10-14 Update PCB files and tutorials
    [BOM_SMT_TB_RFM95_868_IISS_PCB4_1.xlsx]
2023-10-14 Update PCB README files
2023-10-14 Update PCB pictures
2023-10-16 Update SX12XX lib for better power management needed for solar version
2023-10-17 Update tutorials with new PCBs & boards
2023-10-21 fix power bug for analog sensors with solar board & optimize for TTN
    [BoardSettings.h]
2023-10-28 Update PCB Gerber, BOM and CPL files for PCB Assembly
    [BOM_SMT_TB_RFM95_868_IISS_PCB4_1.xlsx, BOM_SMT_TB_RFM95_868_IISS_PCB4_1_wH2.xlsx, BOM_SMT_TB_RFM96_433_IISS_PCB4_1_wH2.xlsx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]
2023-10-28 Update tutorials for PCB Assembly
2023-10-29 Update tutorials for PCBA
2023-10-30 Update tutorial and PCBA images with correct polarity
    [CPL.csv]
2023-11-06 update tutorial for 3xAAA NiMh battery holder
2023-11-18 Update PCBA files & tutorials
    [BOM_SMT_TB_RFM95_868_IISS_PCB4_1_wH2.xlsx, BOM_SMT_TB_RFM96_433_IISS_PCB4_1_wH2.xlsx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]
2024-02-19 Fix A1/VccM powering issue for soil temperature and humidity sensors
    [BoardSettings.h, Intelirris_Soil_Sensor.ino]
2024-02-27 Generalize USB mountpoints in backup procedure
2024-02-27 fix increase of backup capacity -split_000- for 2WTs
2024-04-05 check voltage during TX, without SOLAR_BAT
2024-04-09 send debug voltage values
2024-04-11 des-indent func. declare
2024-04-11 send battery voltage debug values for solar
2024-04-11 improve failsafe on waiting time interval
    [Intelirris_Soil_Sensor.ino]
2024-04-12 impose a sleep after 3 consecutive reboots
    [Intelirris_Soil_Sensor.ino]
2024-04-29 transmit minimal measured voltage for non solar, default first measure
2024-05-06 Update delete device scripts for IIWA
2024-06-26 add reboot as a low voltage indication (lvi); remove lvi reset at setup/reboot
    [Intelirris_Soil_Sensor.ino]
2024-07-10 Add support for the IRD PCB RAK3172 version
2024-07-12 Add IRD PCB v5 related resources
    [BOM_SMT_TB_RAK3172_868_IISS_PCB5.xlsx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]
2024-07-12 Add debug output
    [dump-serial-debug.txt]
2024-07-17 Update tutorial for PCBv5
2024-09-06 Update files for IRD PCBv5
    [BOM_SMT_TB_RAK3172_868_IISS_PCB5.xlsx]
2024-09-26 Update tutorial for assembly instructions
2024-12-01 Update BOM & CPL
    [BOM_SMT_TB_RAK3172_868_IISS_PCB5.xlsx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]
2025-02-18 Update tutorials with explanation of power management
2025-03-23 Last commit – check our last development
